kippkitts/DataSensingLab/README.md

DataSensingLab
==============

DataSensingLab

Here, you’ll find files for the DataSensingLab.  Visit the DataSensingLab [website](http://datasensinglab.com/) for more information.
