kippkitts/DataSensingLab/ONA_Sensor_Mote/Circuit Board/ONA_SensorMote_V1/ONA_SensorMote_FAB/Readme.txt

File names and descriptions:

Excellon drill rack and drill files:
	ONA_SensorMoteV1.drd
	ONA_SensorMoteV1.dri

GERBER_RS274X FILES
Component Side (top, pads, vias)
	ONA_SensorMoteV1.cmp
Solder Side (bottom, pads, bias)
	ONA_SensorMoteV1.sol
Silk screen Component side (dimension, tPlace, tNames)
	ONA_SensorMoteV1.plc
Solder Stop Mask Component Side (tStop)
	ONA_SensorMoteV1.stc
Solder Stop Mask Solder Side (bStop)
	ONA_SensorMoteV1.cmp

Kipp Bradford
Principal
The Kippworks

999 Main Street
Suite 705
Pawtucket RI 02860
USA

(401)480-7972
kb@kippworks.com
