kippkitts/DataSensingLab/ONA_Sensor_Mote/Circuit Board/BOM and Datasheets/ONA_SensorMoteBOM_V1.xlsx

REF # | Qty | Value | Device | Package | Parts | Description | Digikey | MF | MPN
ONA-1 | 1 | BAT | BAT1 | 4AA | BAT1 | Battery Pack | SBH341AS-ND
ONA-2 | 1 |  | DNP | DNP | 6V In | Battery Pack Solder Pads
ONA-3 | 1 |  | M03LOCK | 1X03_LOCK | JP1 | 0.1" Pin Header for Motion Detector
ONA-4 | 1 |  | M04SMD | 1X04-SMD | JP2, JP3 optional | 0.1" Pin Header for Programming |  |  |  | 3M9502CT-ND
ONA-5 | 1 | 0.01uF | C-EUC0805K | C0805K | C6 | CAPACITOR, European symbol | 1276-1015-1-ND
ONA-6 | 7 | 0.1uF | C-EUC0805K | C0805K | C3, C5, C11, C13, C14, C15, C18 | CAPACITOR, European symbol | 399-1170-1-ND
ONA-7 | 1 | 100pF | C-EUC0805K | C0805K | C8 | CAPACITOR, European symbol | 399-1121-1-ND
ONA-8 | 1 | 10uF | C-EUC0805K | C0805K | C7 | Capacitor, Non-Polarized 0805 | 587-1300-1-ND
ONA-9 | 4 | 1nF | C-EUC0805K | C0805K | C4, C9, C10, C12 | CAPACITOR, European symbol | 399-1147-1-ND
ONA-10 | 3 | 10uF | CAP_POL1206 | EIA3216 | C1, C2, C17 | Capacitor Polarized Tantalum Supply Filter | 399-3687-1-ND
ONA-11 | 1 | 47R | R-EU_R0805 | R0805 | R13 | RESISTOR, European symbol | 311-47ARCT-ND
ONA-12 | 1 | 100R | R-EU_R0805 | R0805 | R16 | RESISTOR, European symbol | RHM100CLCT-ND
ONA-13 | 3 | 1K | R-EU_R0805 | R0805 | R6, R7, R10 | RESISTOR, European symbol | RHM1.0KCLCT-ND
ONA-14 | 4 | 10K | R-EU_R0805 | R0805 | R1, R12, R14, R17 | RESISTOR, European symbol | RMCF0805JT10K0CT-ND
ONA-15 | 1 | 22K | R-EU_R0805 | R0805 | R11 | RESISTOR, European symbol | 311-22KARCT-ND
ONA-16 | 1 | 47k | R-EU_R0805 | R0805 | R2 | RESISTOR, European symbol | RMCF0805JT47K0CT-ND
ONA-17 | 3 | 1M | R-EU_R0805 | R0805 | R3, R8, R9 | RESISTOR, European symbol | RHM1.00MCHCT-ND
ONA-18 | 2 | 1K | 4R-NCAY16 | CAY16 | RN1, RN2 | Array Chip Resistor | Y9102CT-ND
ONA-19 | 1 | TC33X-2-1-4E (100K) | TRIMPOTTC33X | TC33X | VR1 | SMT trimmer potentiometer part number TC33X | TC33X-104ECT-ND
ONA-20 | 2 | YELLOW | LEDCHIP-LED0805 | CHIP-LED0805 | RSSI, RX | LED | 475-2560-1-ND
ONA-21 | 1 | Blue | LEDCHIP-LED0805 | CHIP-LED0805 | ACT | LED | 160-1579-1-ND
ONA-22 | 1 | White | LEDCHIP-LED0805 | CHIP-LED0805 | XB_ON | LED | 160-1738-1-ND
ONA-23 | 2 | Red | LEDCHIP-LED0805 | CHIP-LED0805 | AQ, ASSOC | LED | 350-2039-1-ND
ONA-24 | 2 | Green | LEDCHIP-LED0805 | CHIP-LED0805 | MOT, TX | LED | 475-1410-1-ND
ONA-25 | 1 | CMA-4544PF-W | ELECTRET | 9.7ELECTRET | Q3 | Electret microphone | 102-1721-ND
ONA-26 | 1 | MSP430G2553 | MSP430G2553 | PW20 | IC9 | MSP430G2553 | 296-28430-1-ND
ONA-27 | 1 | GAS_SENSOR | GAS_SENSOR | MQ-3 | U7 | MQ-3 Gas Sensor. FP not tested. Part# |  | IN HAND
ONA-28 | 1 |  | MAX4466SC70 | SC70-5L | U5 | MAX4466 Mic Amp
ONA-29 | 1 | LM61 | LM61 | SOT23 | IC4 | Temperature Sensor | LM61BIM3X/NOPBCT-ND | TI | LM61
ONA-30 | 1 | LT5534 | LTC55 | SC70 | U6 | RF Signal Detector | LT5534ESC6#TRMPBFCT-ND
ONA-31 | 1 | MC33269ST-3.3T3 | MC33269ST-3.3T3 | SOT223 | IC1 | Adjustable Output Low Dropout Voltage Regulator 800 mA | MC33269ST-3.3T3GOSCT-ND
ONA-32 | 1 | MC33269ST-3.3T3 | MC33269ST-3.3T3 | SOT223 | IC2 | Adjustable Output Low Dropout Voltage Regulator 800 mA | NCP1117ST50T3GOSCT-ND
ONA-33 | 1 | MOSFET-NCHANNELSMD | MOSFET-NCHANNELSMD | SOT23-3 | Q1 | 1A Logic Level Mosfet | 785-1009-1-ND
ONA-34 | 1 | TS42 | TS42 | TS42 | RESET | TS42 | 679-2379-1-ND
ONA-35 | 1 | XBEE-SMT | XBEE-SMT | XBEE-SMT | SM34 | XB1 |  | XBee(TM)/XBee-PRO(TM) ZB SMT RF Modules.
ONA-36 | 2 | XBEE-HEADER | XBEE-PRO | XBEE-PRO | XB2 | XBee (TM) /XBee-PRO™ HEADER | S5751-10-ND |  | XBP24-AWI-001
ONA-37 | 2 | ferrite | INDUCTOR0603 | 603 | L1, L2 | Inductors | 445-1552-1-ND
 |  |  |  |  |  | Battery thing | SLPD-01-BLK-ND
 |  |  |  |  |  | LED | 897-1145-ND
