kippkitts/DataSensingLab/ONA_Sensor_Mote/Circuit Board/ONA_SensorMote_V1/ONA_SensorMoteV1_BRD.pdf

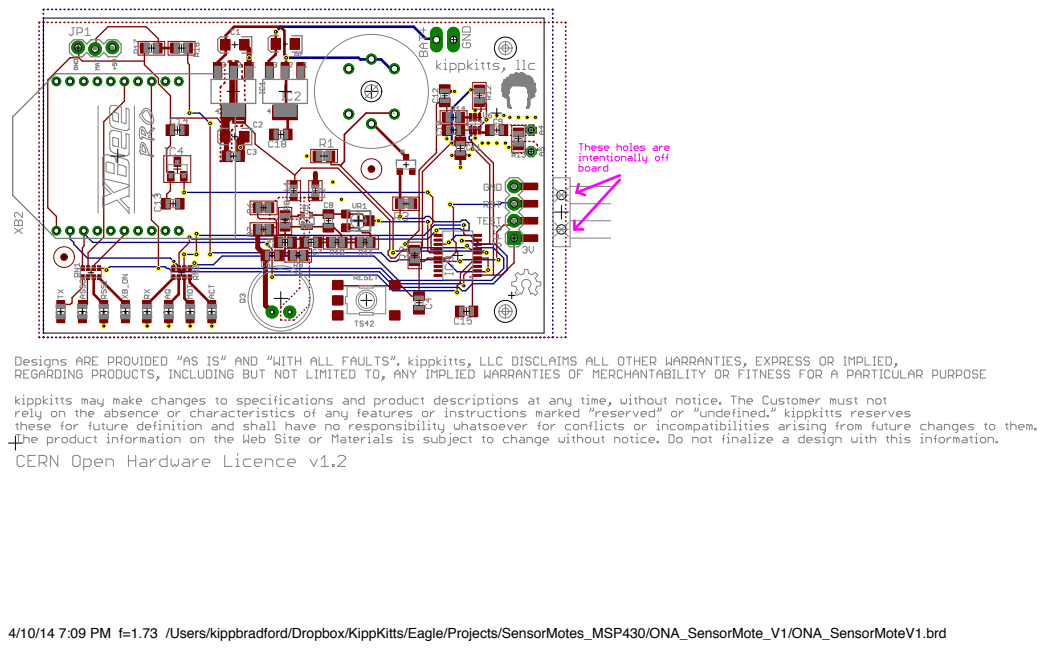
[picture p1: page 1]

4/10/14 7:09 PM f=1.73 /Users/kippbradford/Dropbox/KippKitts/Eagle/Projects/SensorMotes_MSP430/ONA_SensorMote_V1/ONA_SensorMoteV1.brd
