kippkitts/DataSensingLab/ONA_Sensor_Mote/Circuit Board/ONA_SensorMote_V1/ONA_SensorMoteV1_Sch.pdf

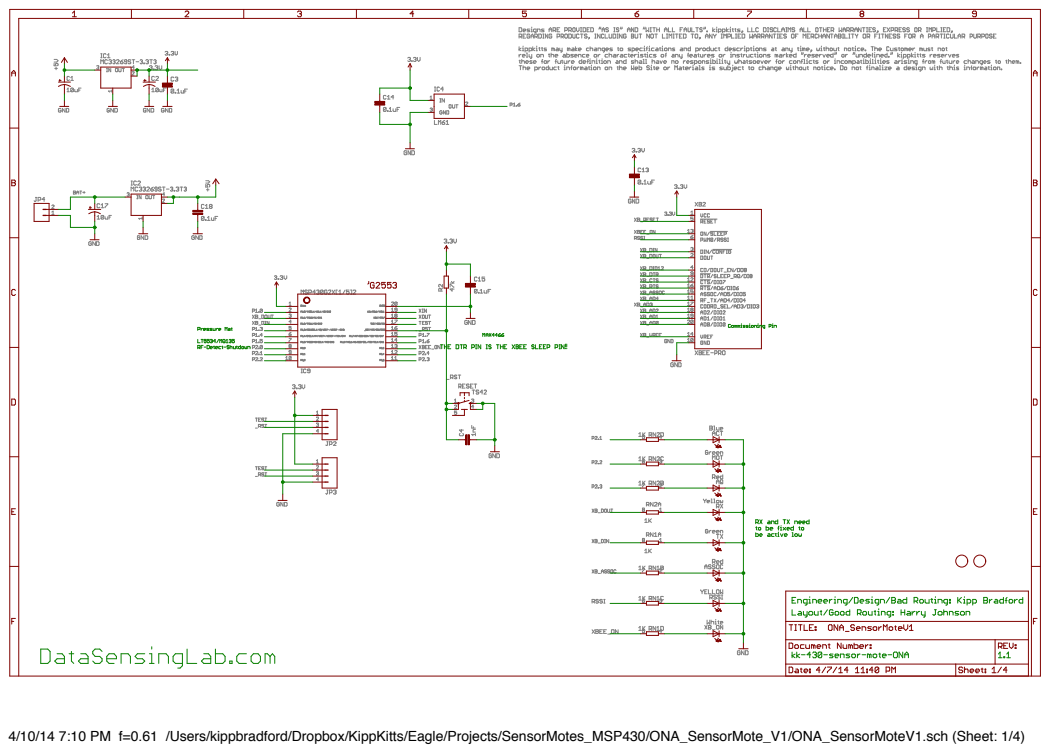
[picture p2: page 1]

4/10/14 7:10 PM f=0.61 /Users/kippbradford/Dropbox/KippKitts/Eagle/Projects/SensorMotes_MSP430/ONA_SensorMote_V1/ONA_SensorMoteV1.sch (Sheet: 1/4)

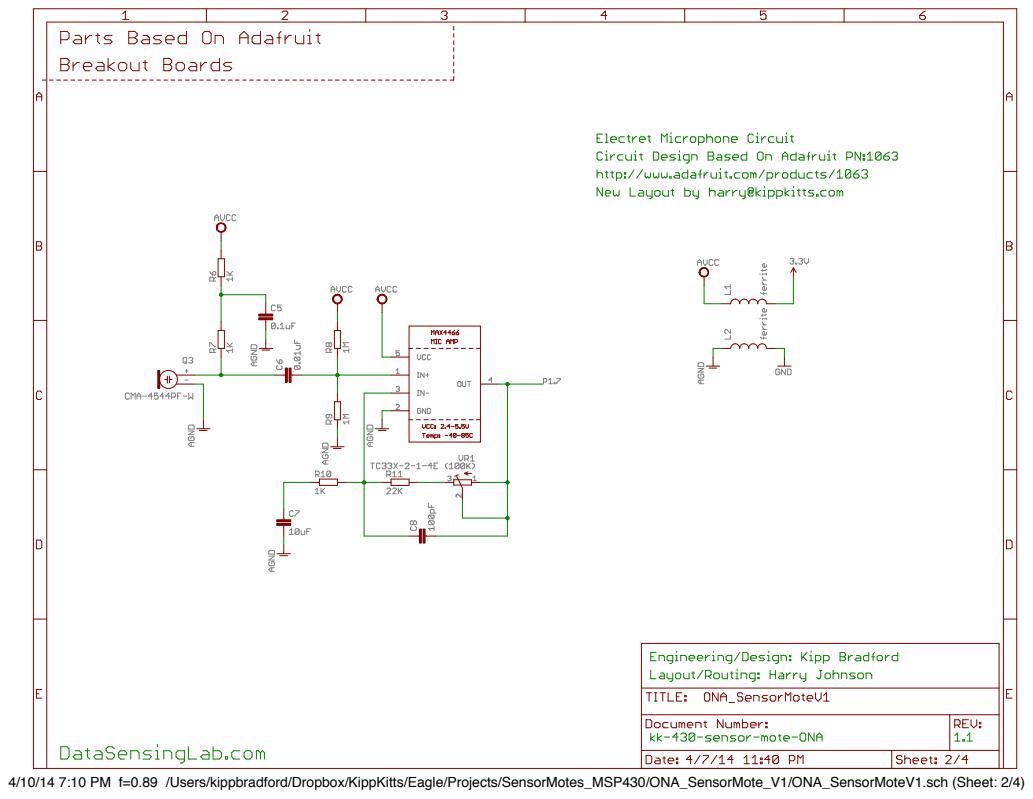
[picture p3: page 2]

4/10/14 7:10 PM f=0.89 /Users/kippbradford/Dropbox/KippKitts/Eagle/Projects/SensorMotes_MSP430/ONA_SensorMote_V1/ONA_SensorMoteV1.sch (Sheet: 2/4)

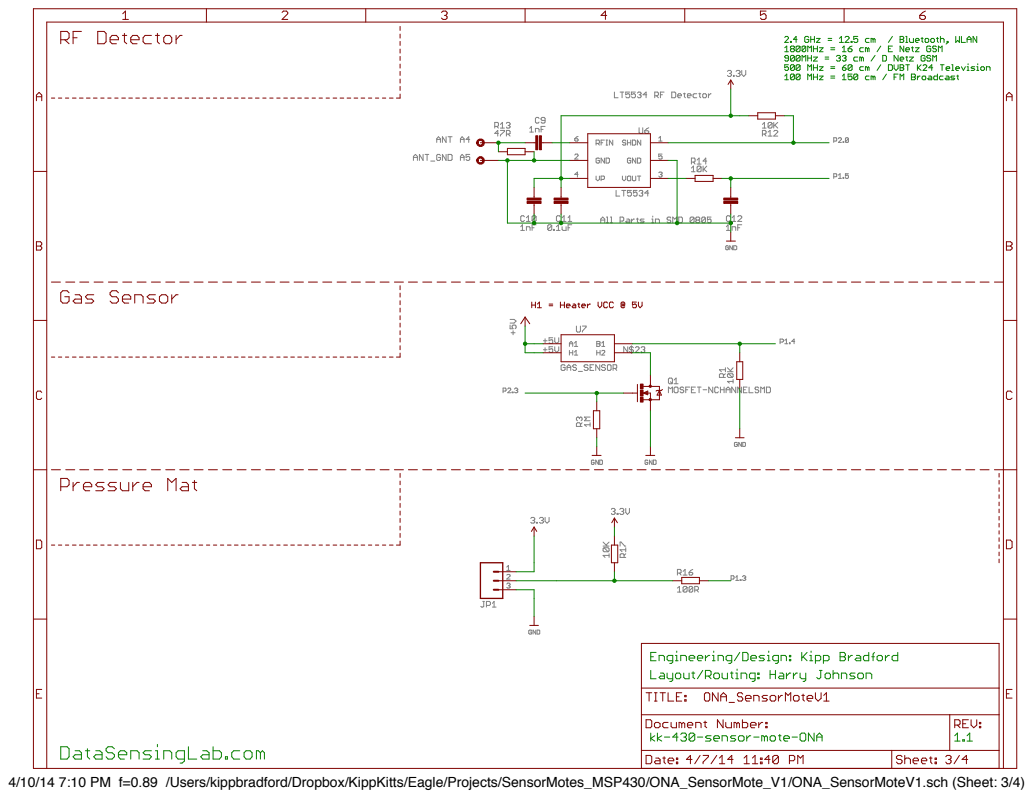
[picture p4: page 3]

4/10/14 7:10 PM f=0.89 /Users/kippbradford/Dropbox/KippKitts/Eagle/Projects/SensorMotes_MSP430/ONA_SensorMote_V1/ONA_SensorMoteV1.sch (Sheet: 3/4)

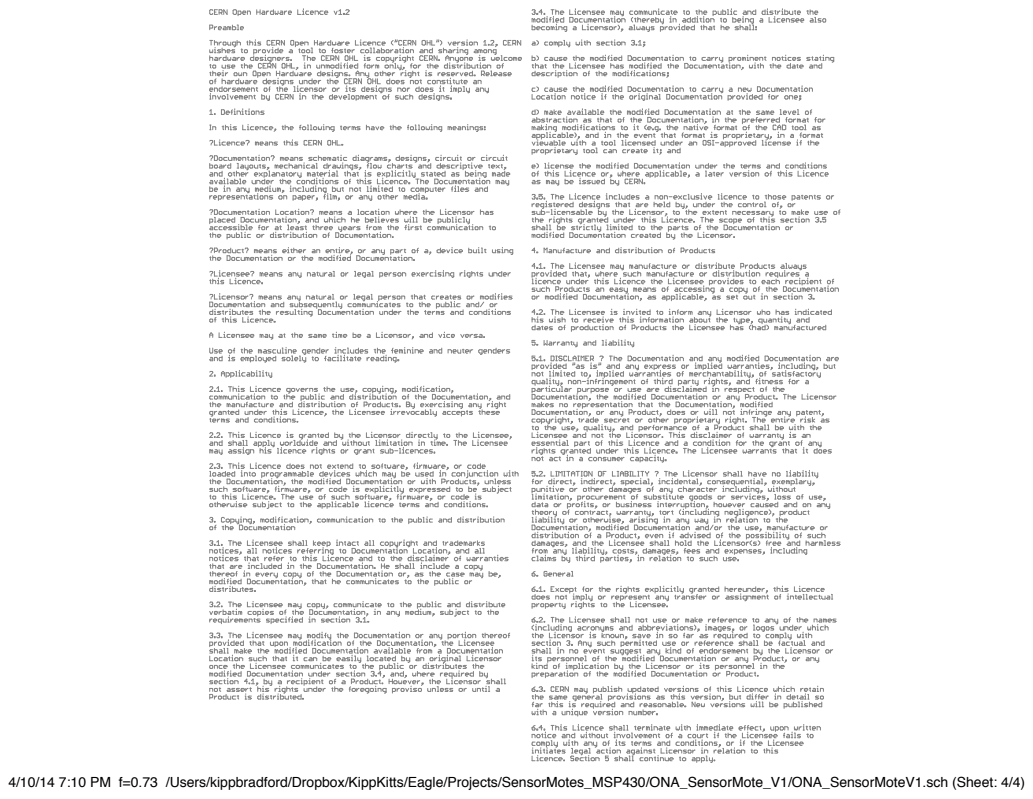
[picture p5: page 4]

4/10/14 7:10 PM f=0.73 /Users/kippbradford/Dropbox/KippKitts/Eagle/Projects/SensorMotes_MSP430/ONA_SensorMote_V1/ONA_SensorMoteV1.sch (Sheet: 4/4)
