kippkitts/DataSensingLab/DSL_Sensor_Mote/Eagle/SensorMoteSMT_V1.1Config0_PCB.pdf

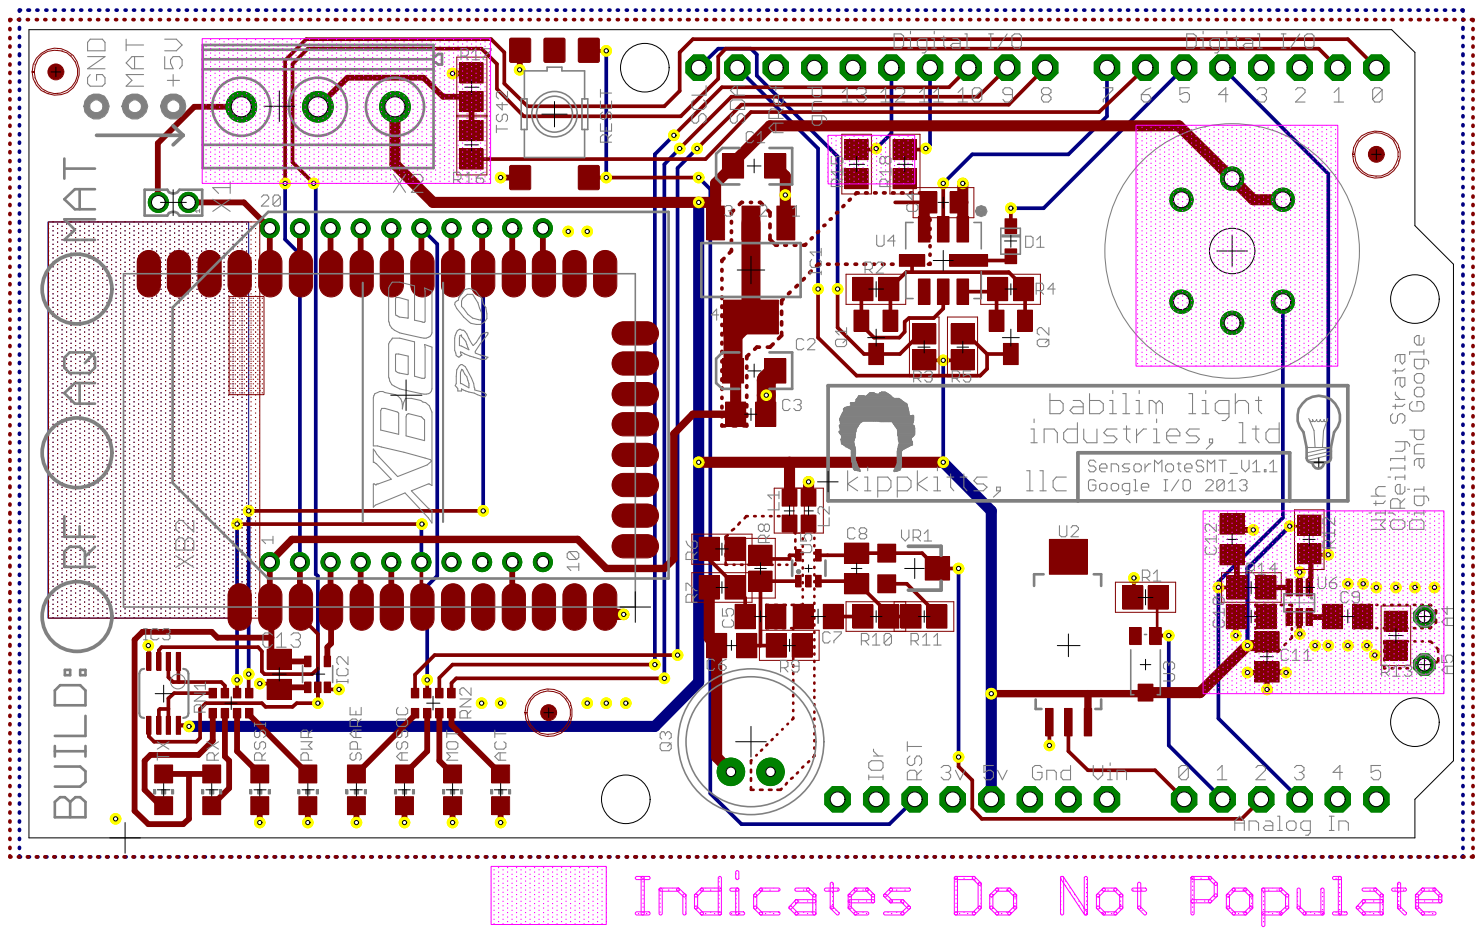
[picture p6: page 1]
