kippkitts/DataSensingLab/DSL_Sensor_Mote/Eagle/SensorMoteSMT_V1.1Config0_SCH.pdf

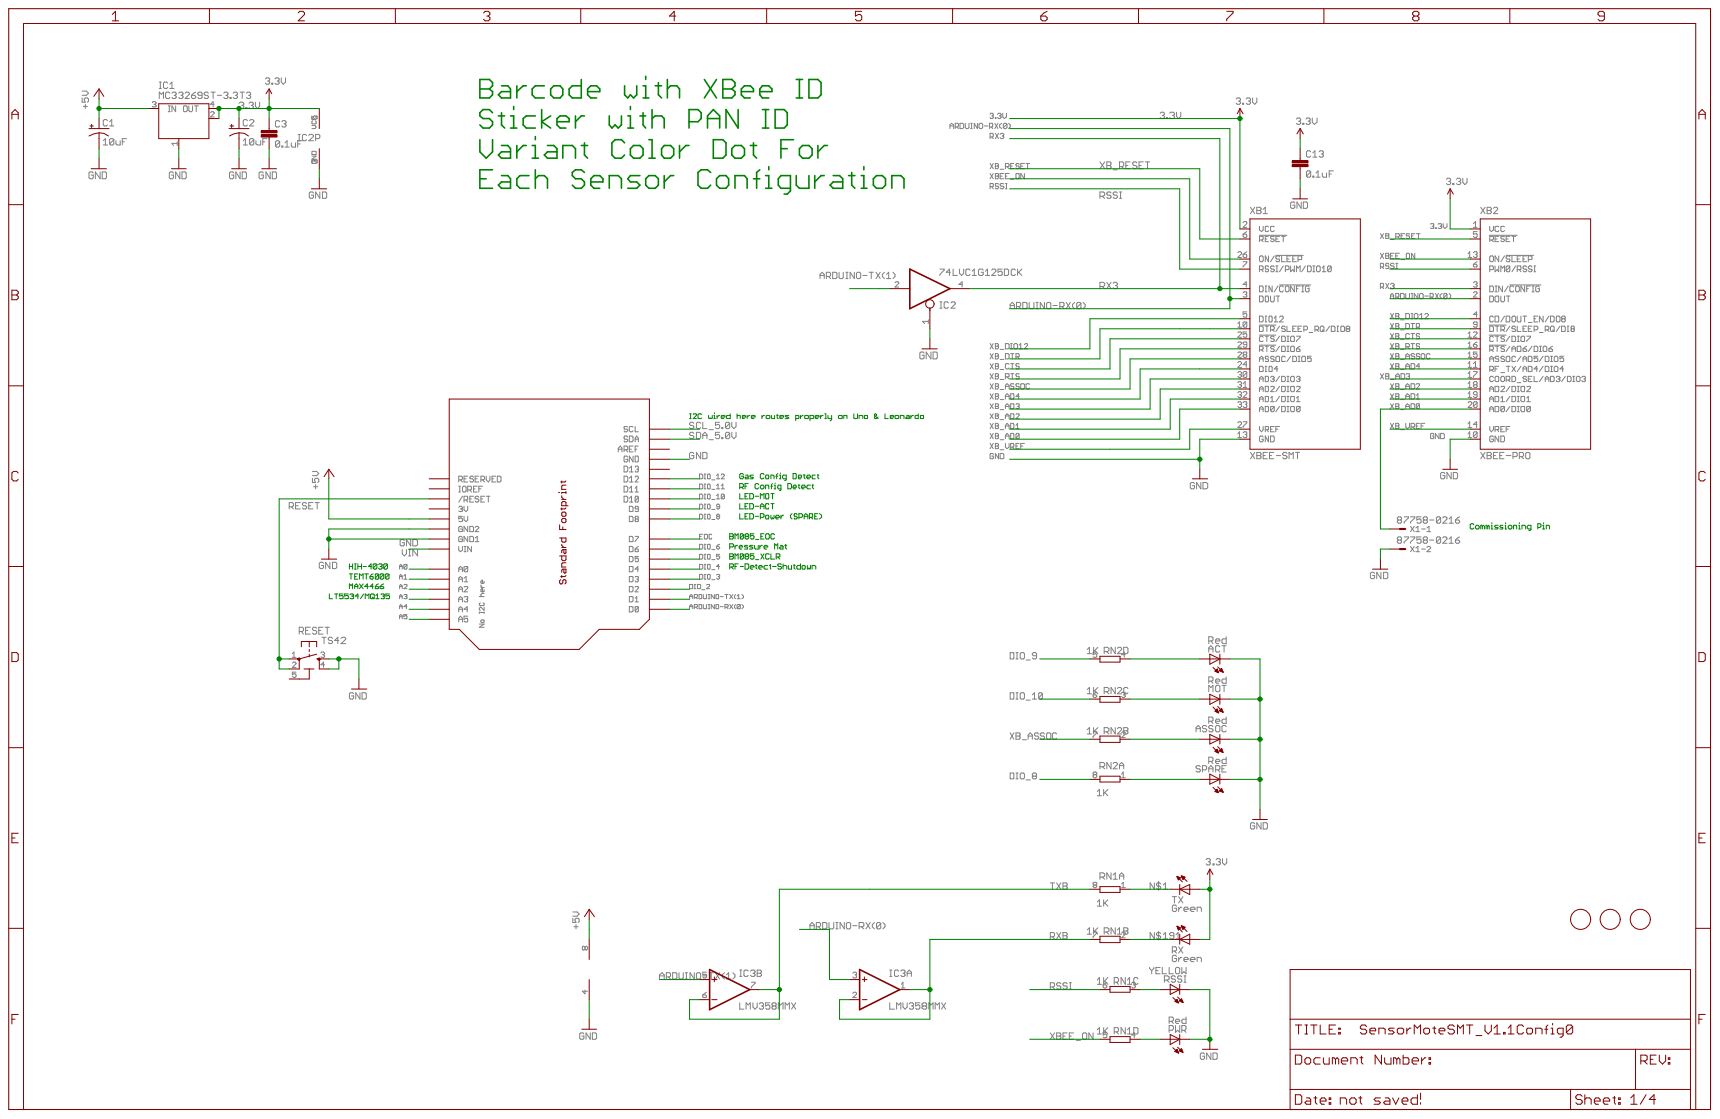
[picture p7: page 1]

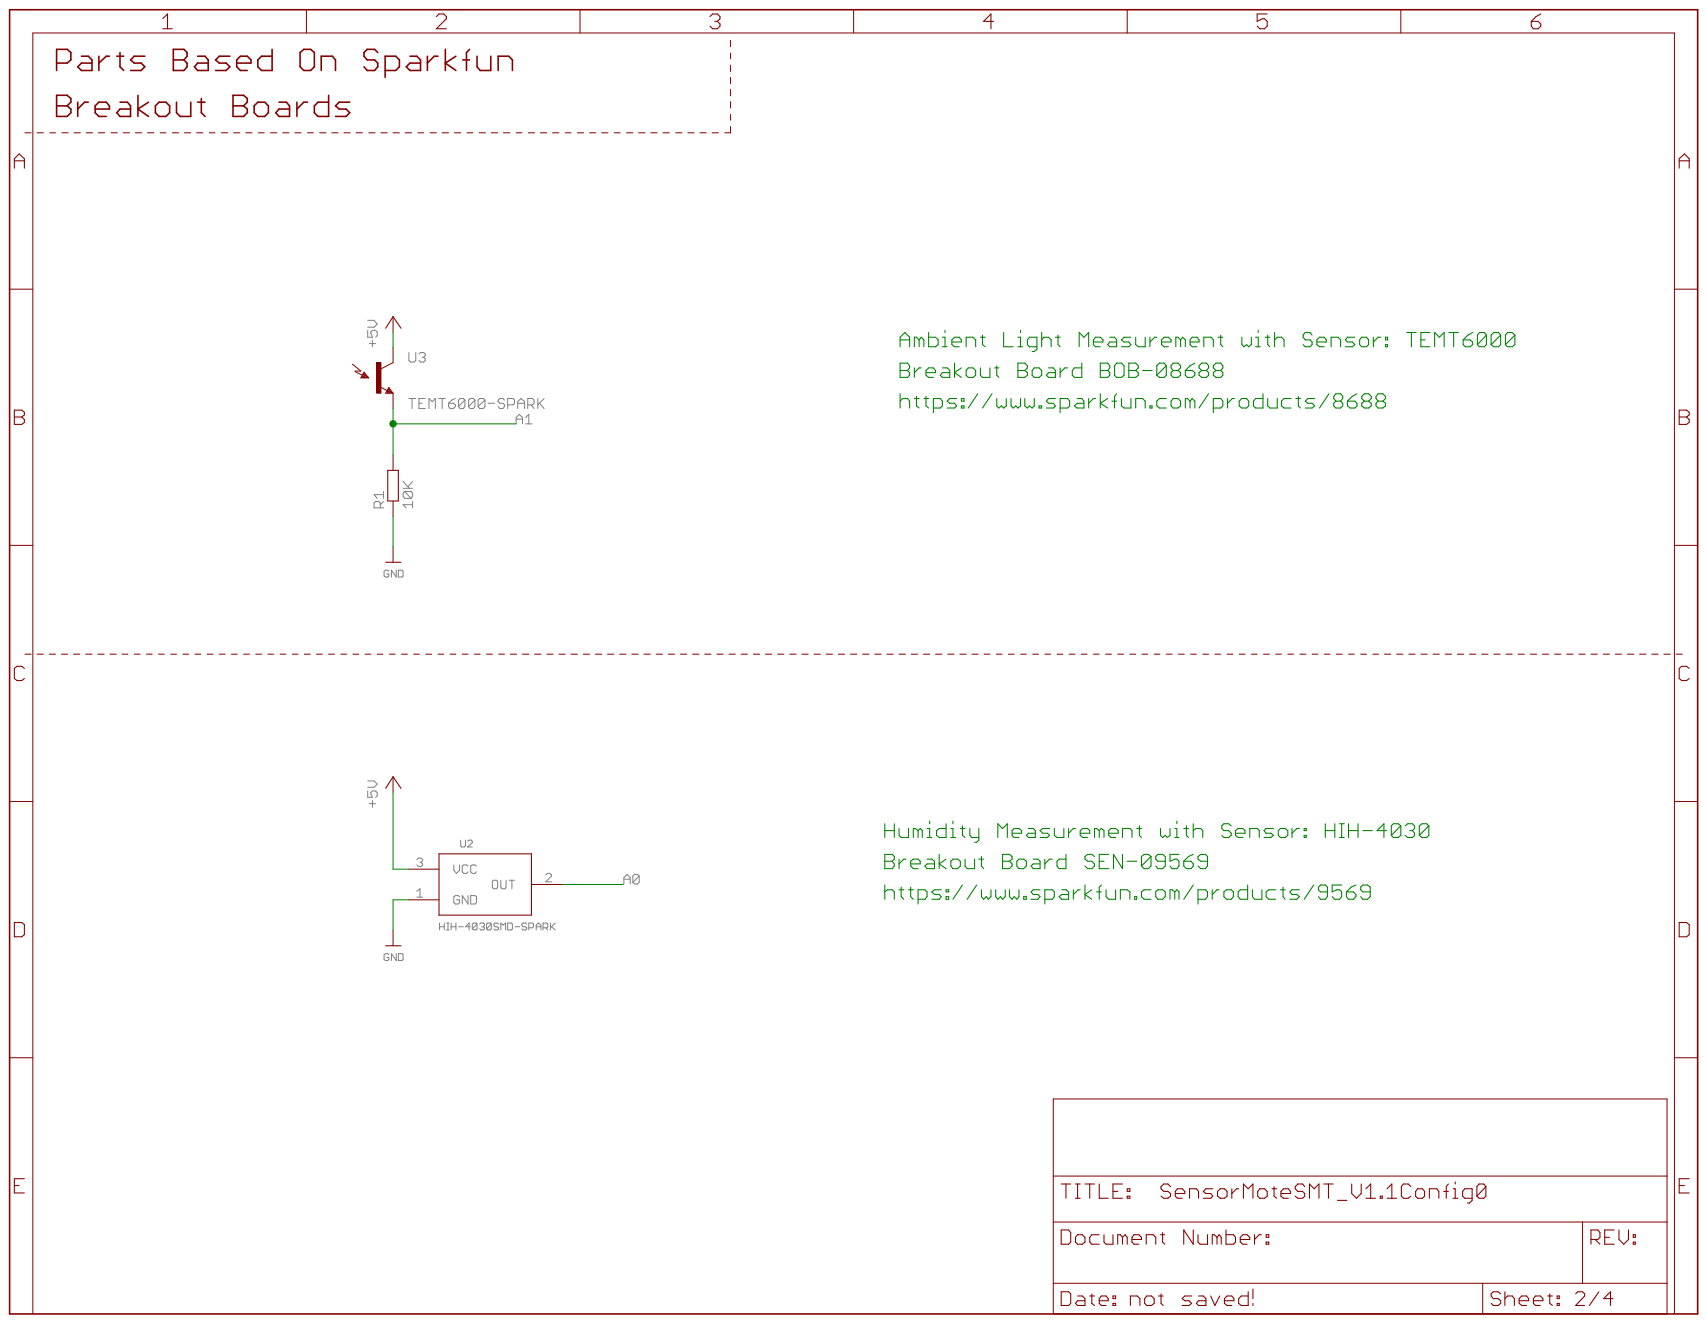
[picture p8: page 2]

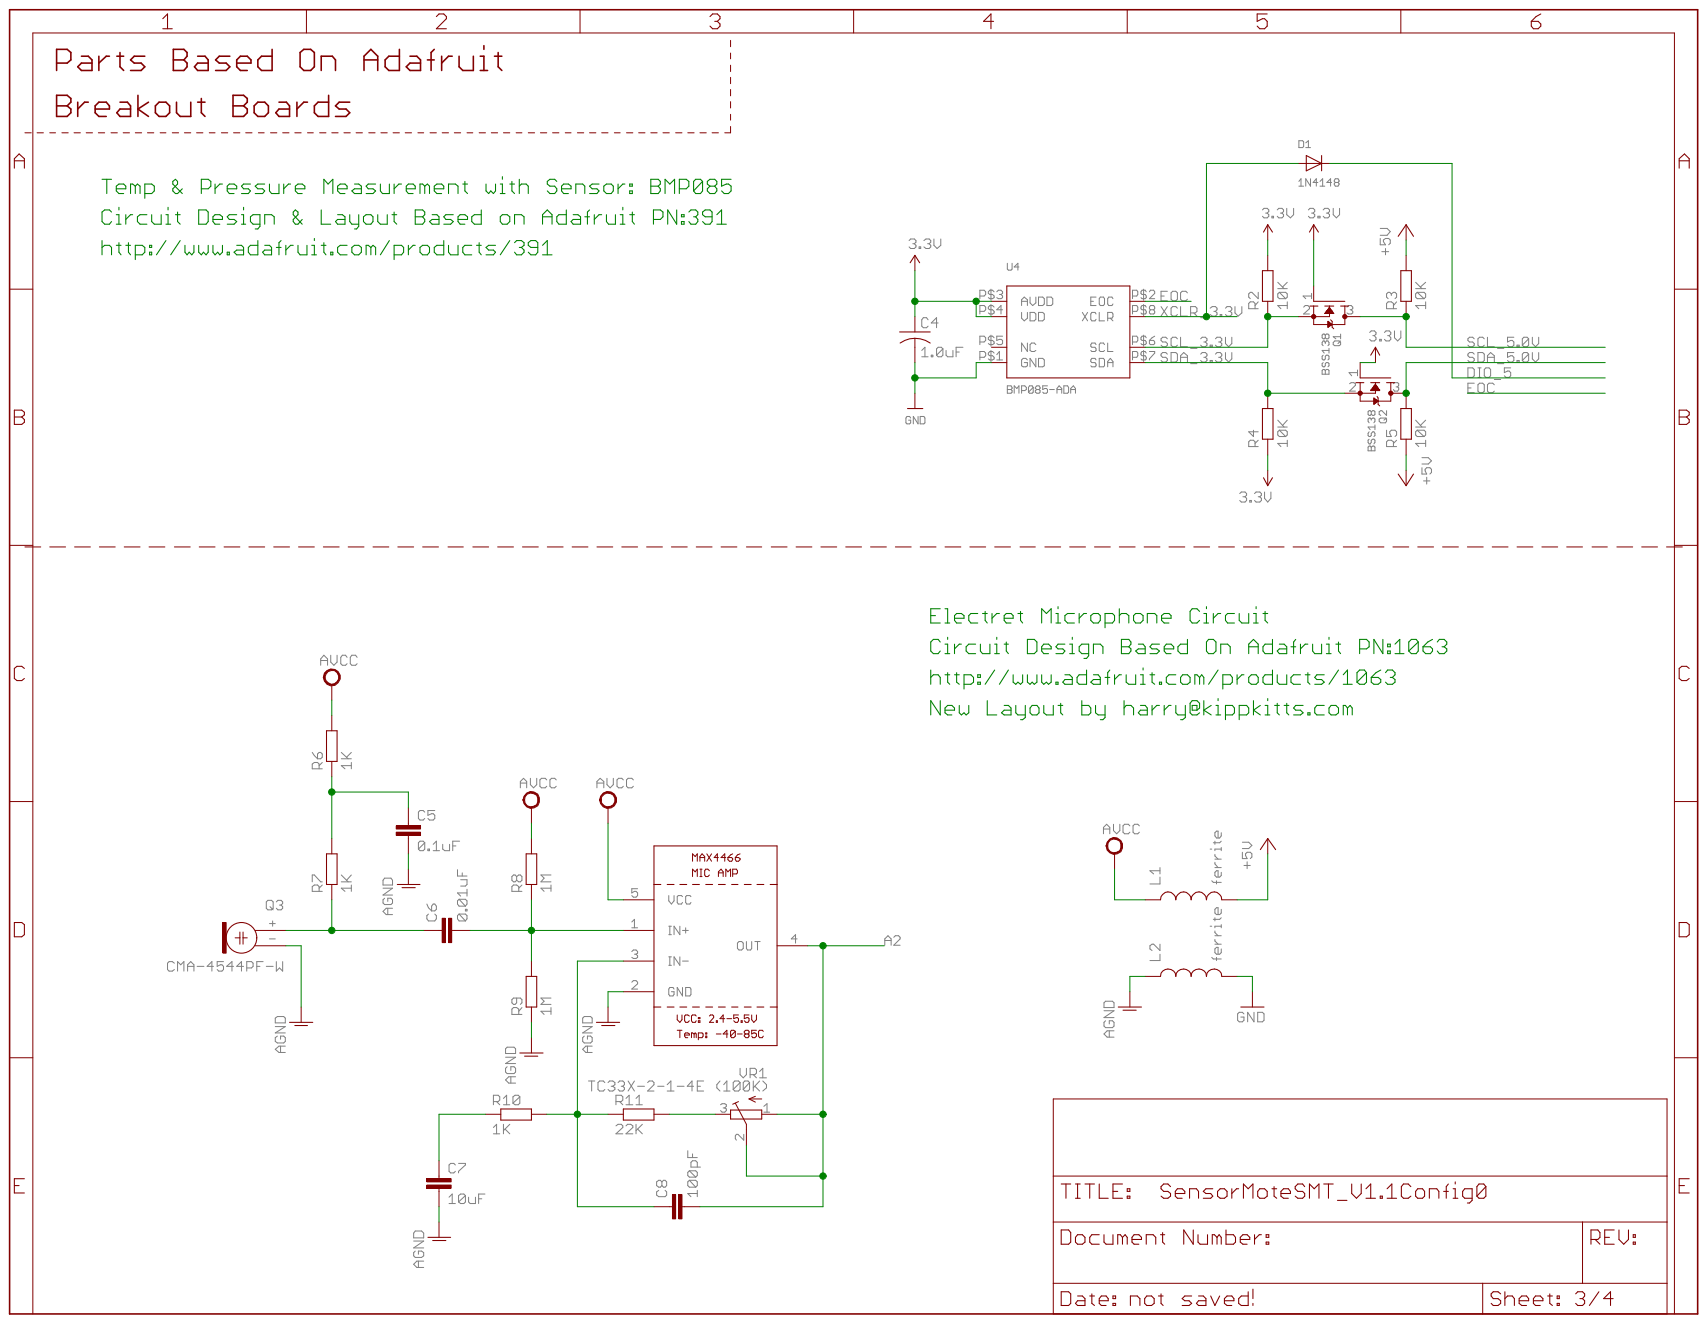
[picture p9: page 3]

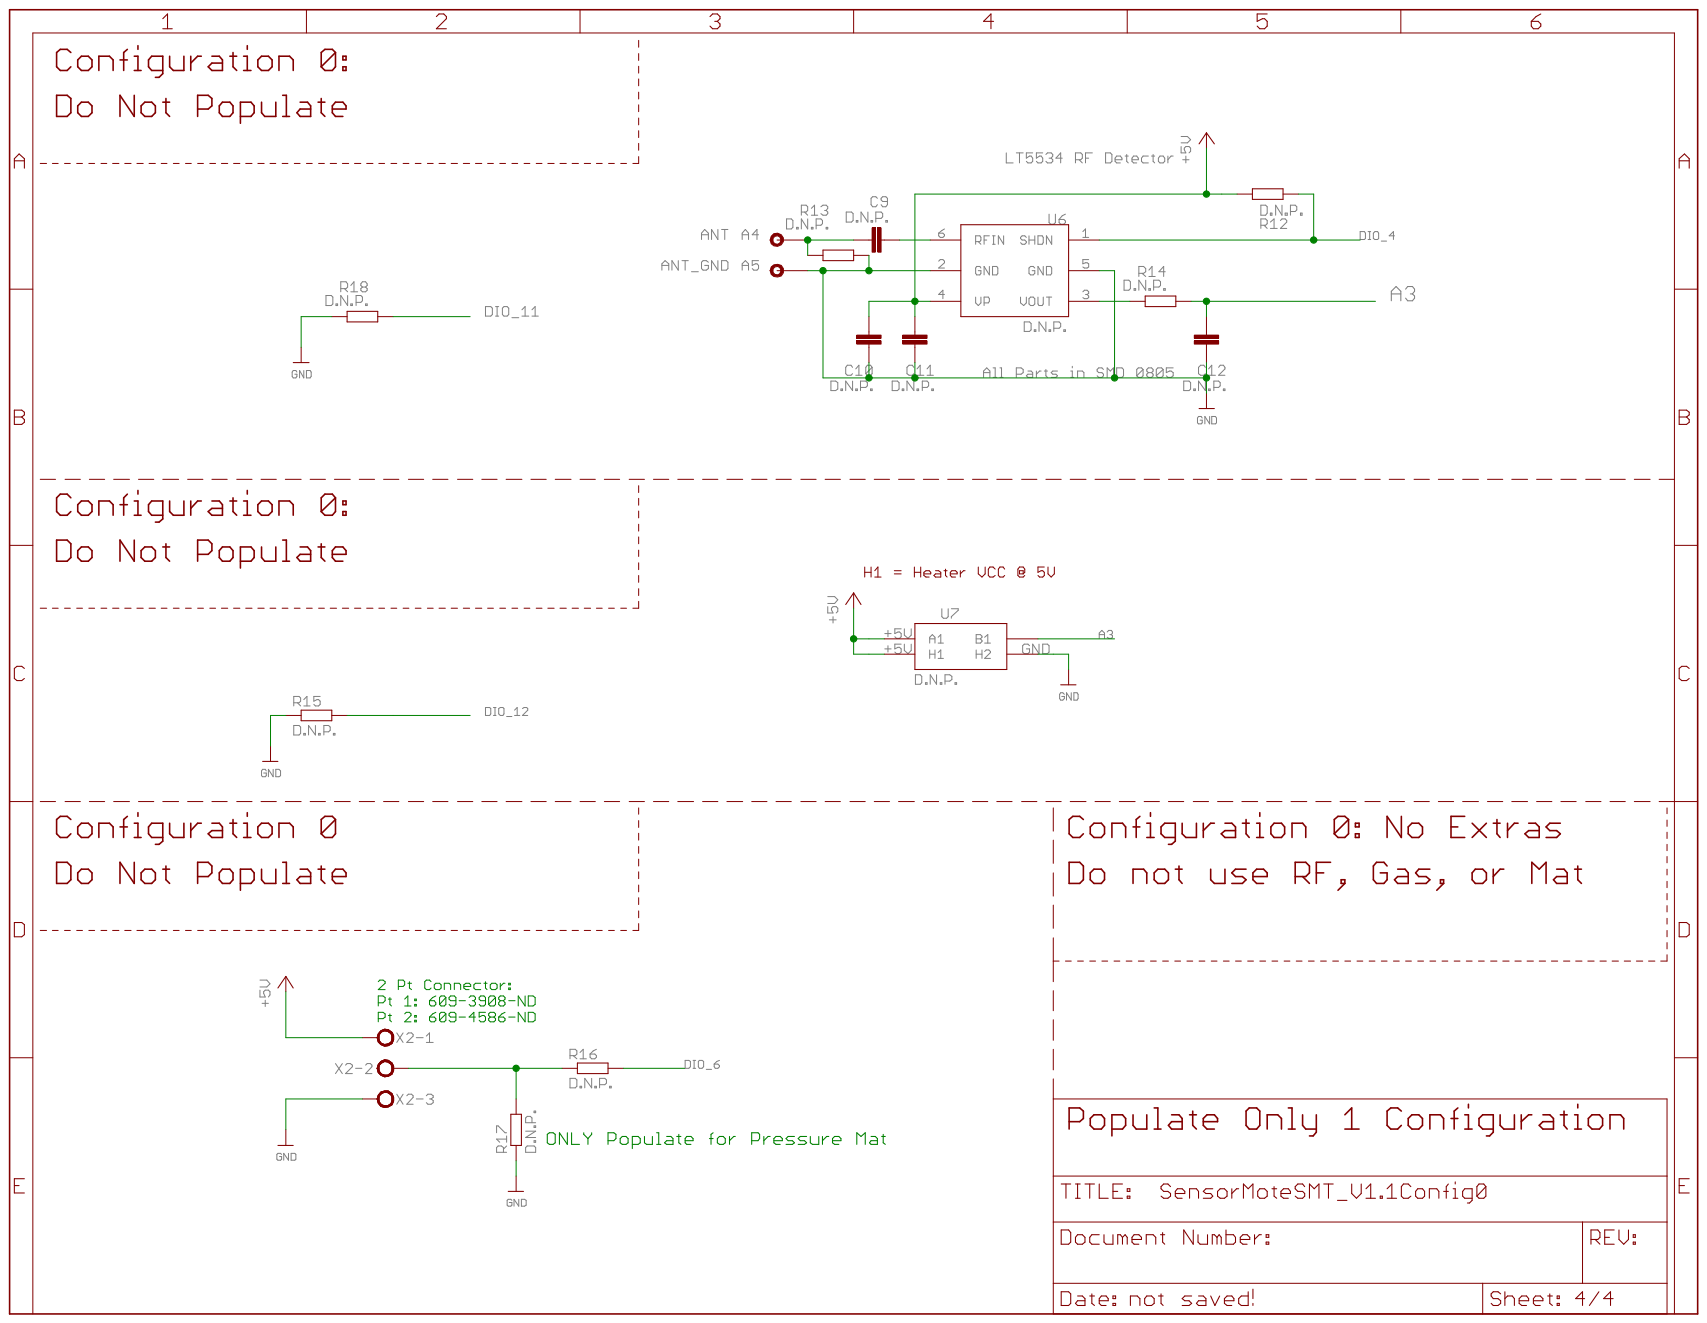
[picture p10: page 4]
