kippkitts/DataSensingLab/DSL_Sensor_Mote/Eagle/SensorMoteSMT_V1.1Config2_GAS_PCB.pdf

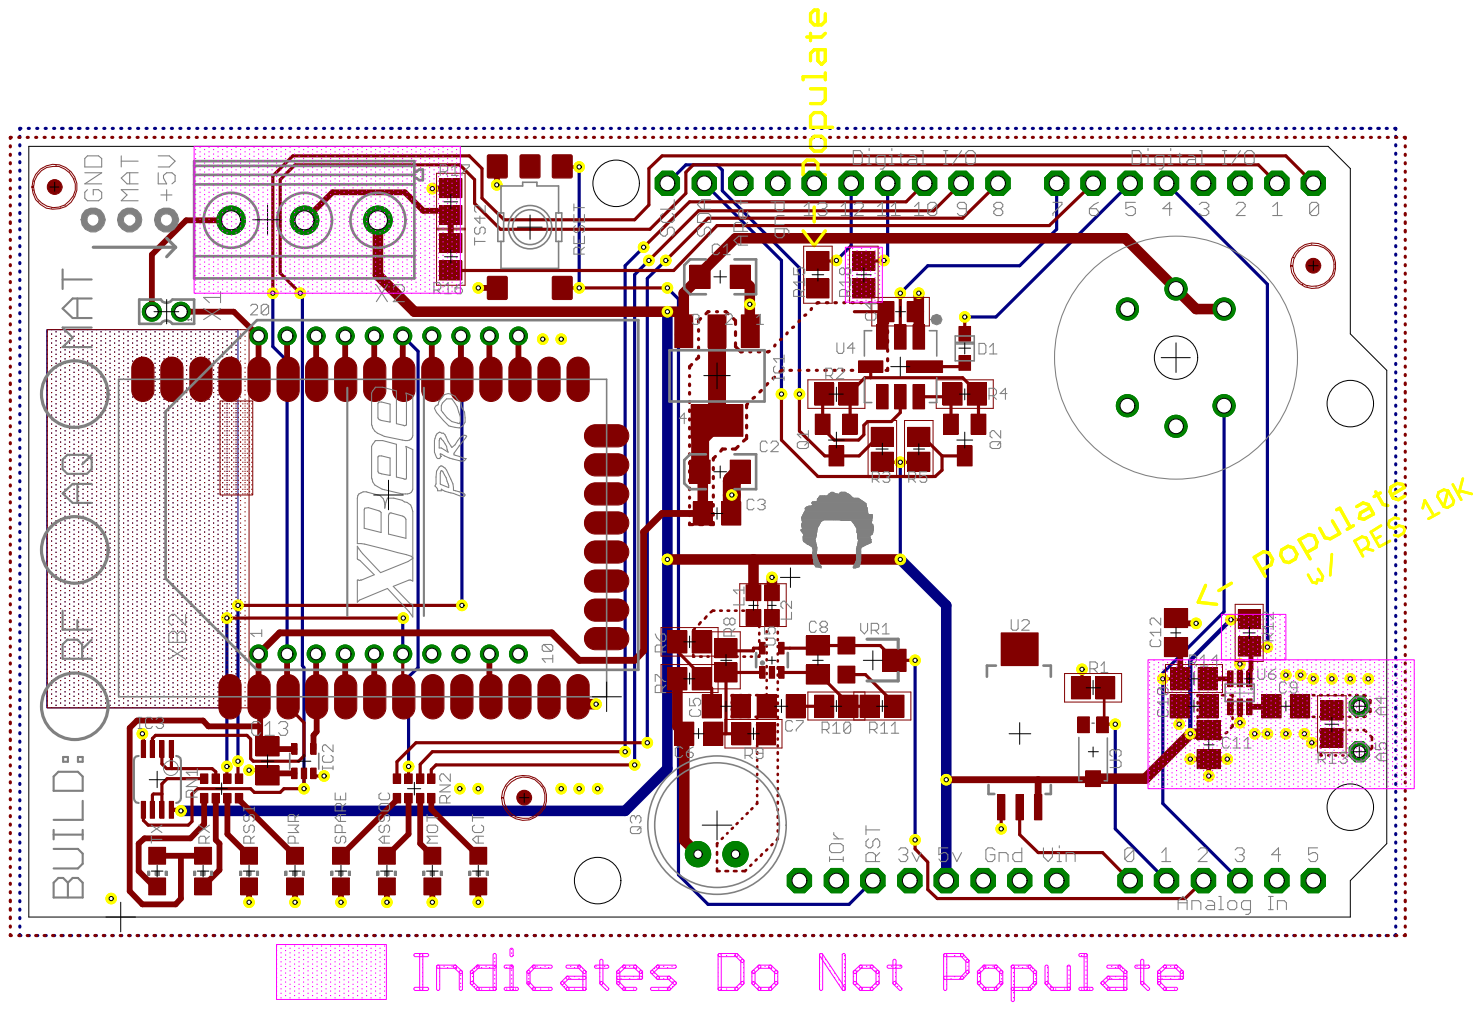
[picture p11: page 1]
