kippkitts/DataSensingLab/DSL_Sensor_Mote/Eagle/SensorMoteSMT_V1.1Config2_GAS_SCH.pdf

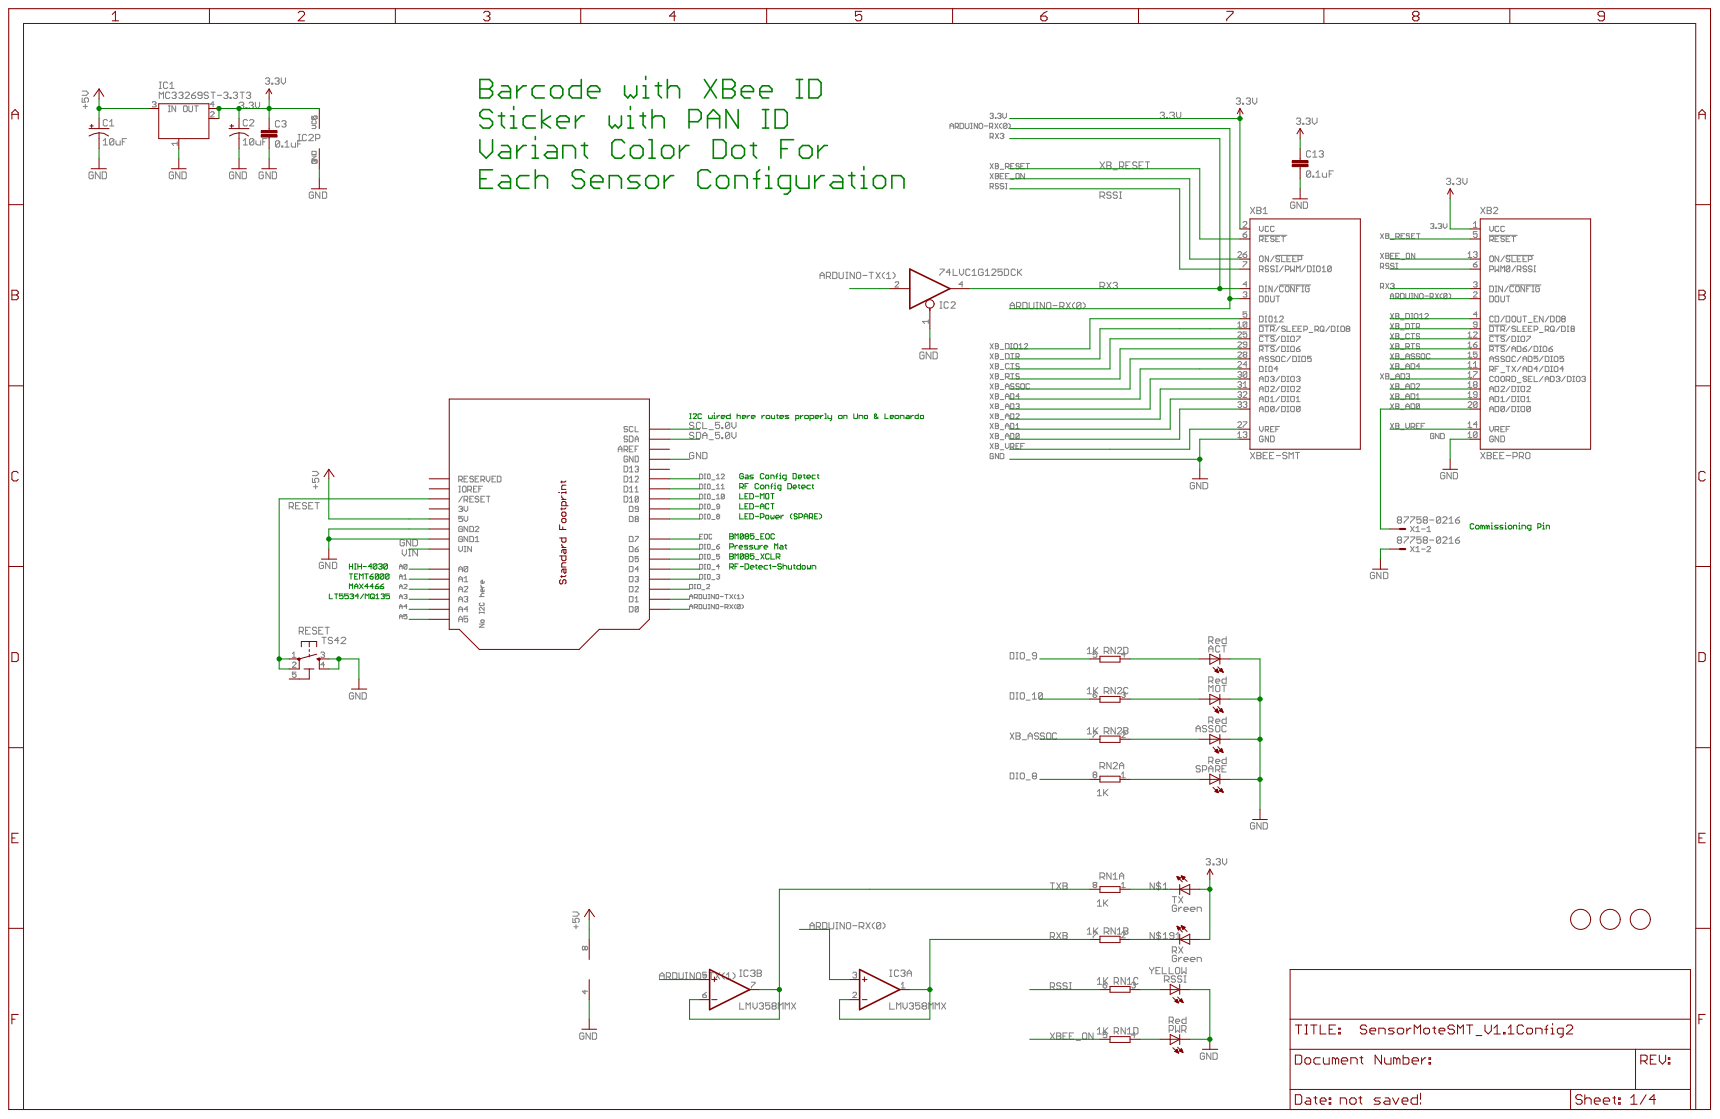
[picture p12: page 1]

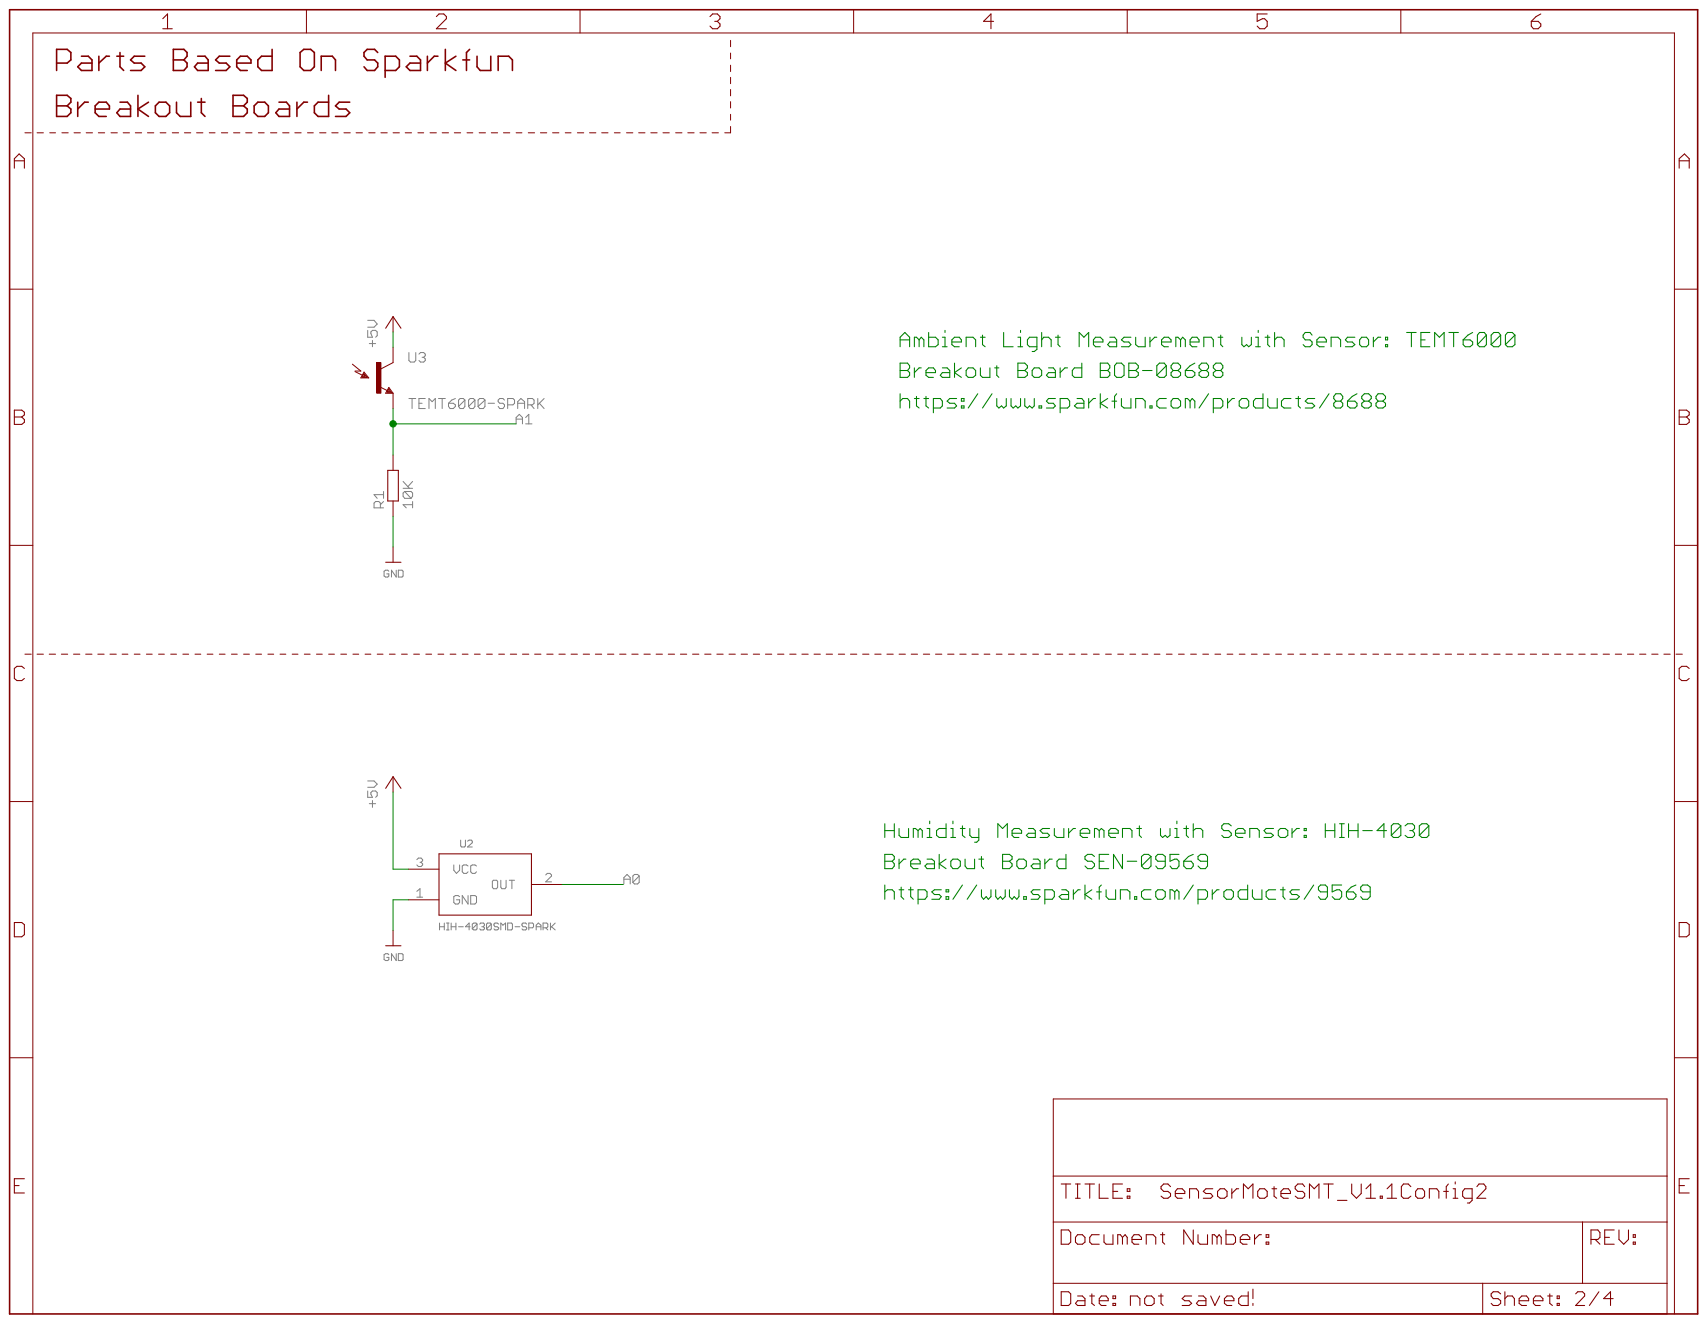
[picture p13: page 2]

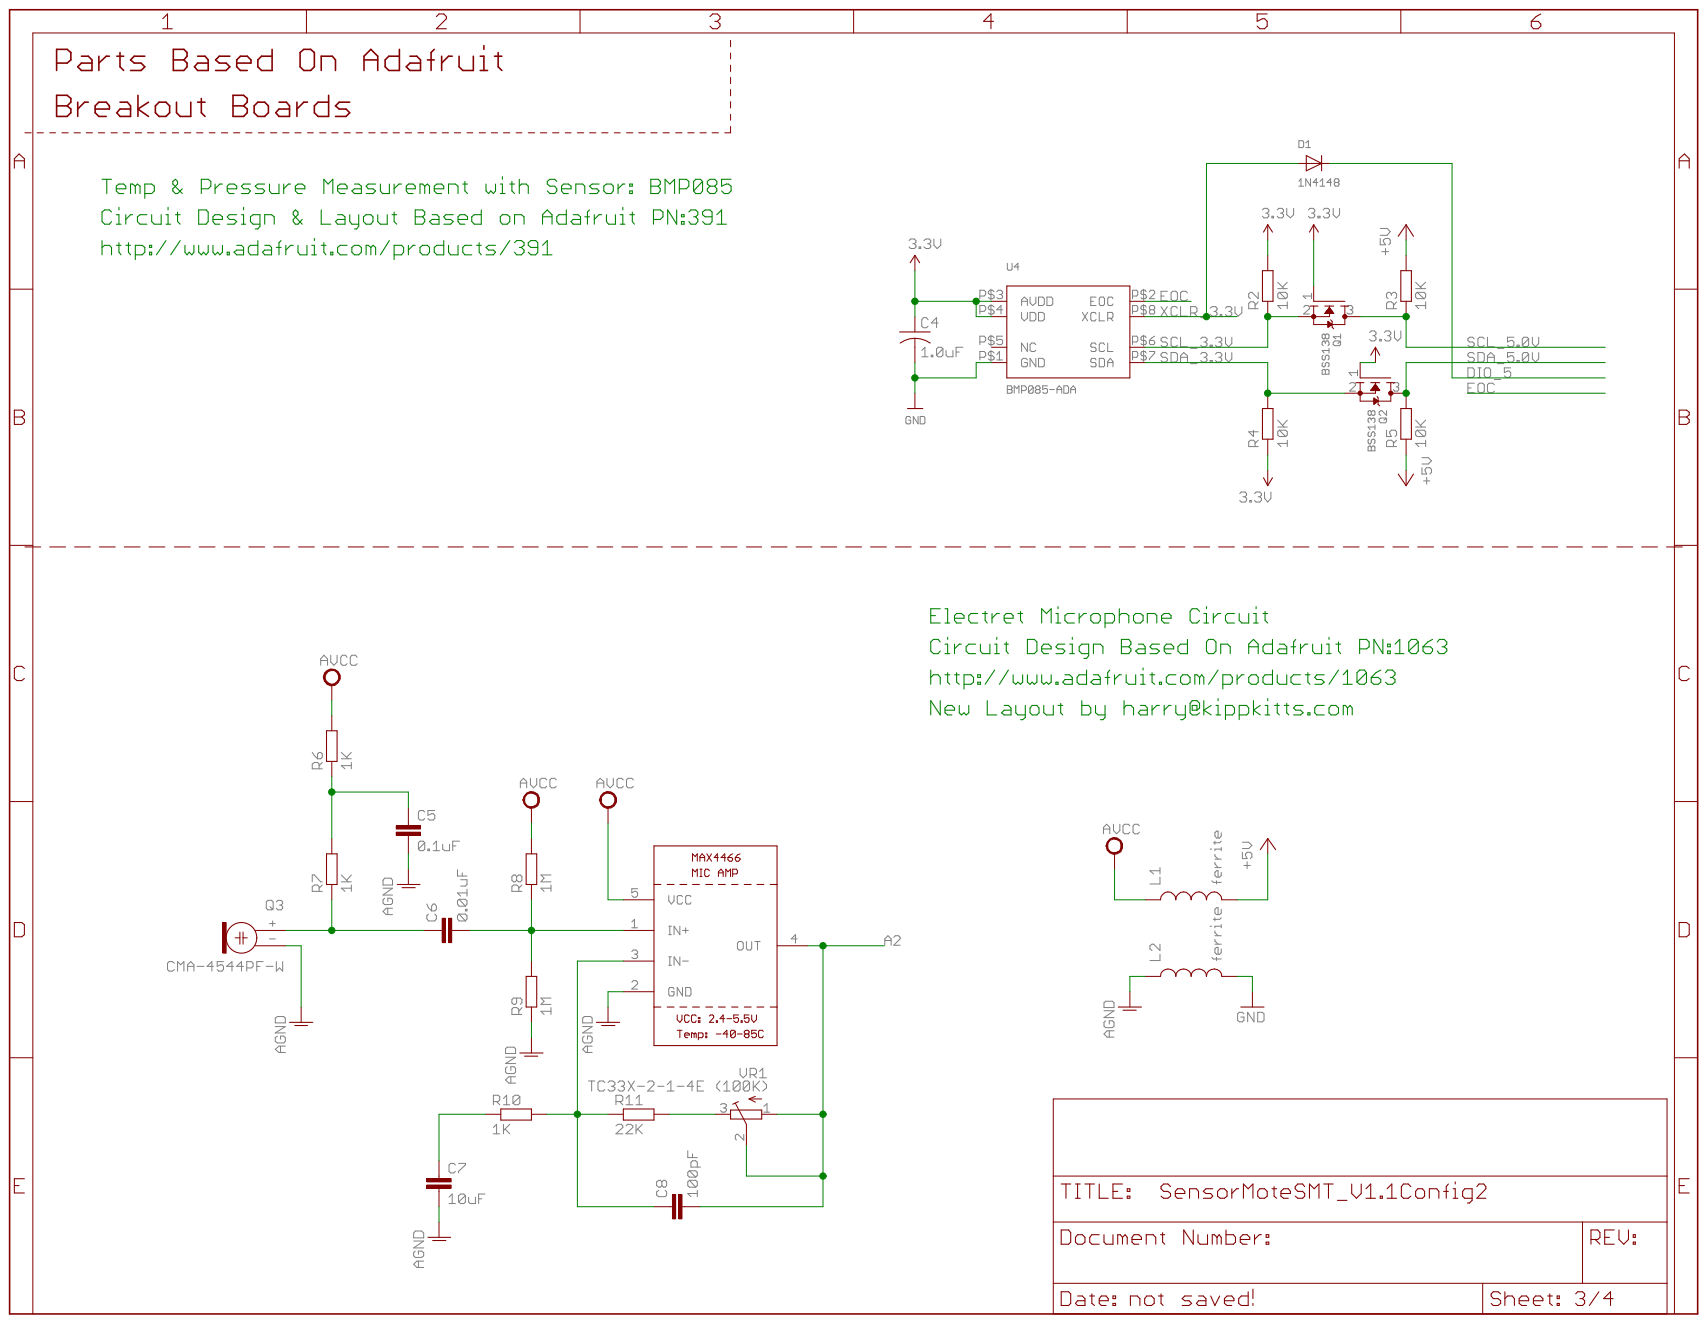
[picture p14: page 3]

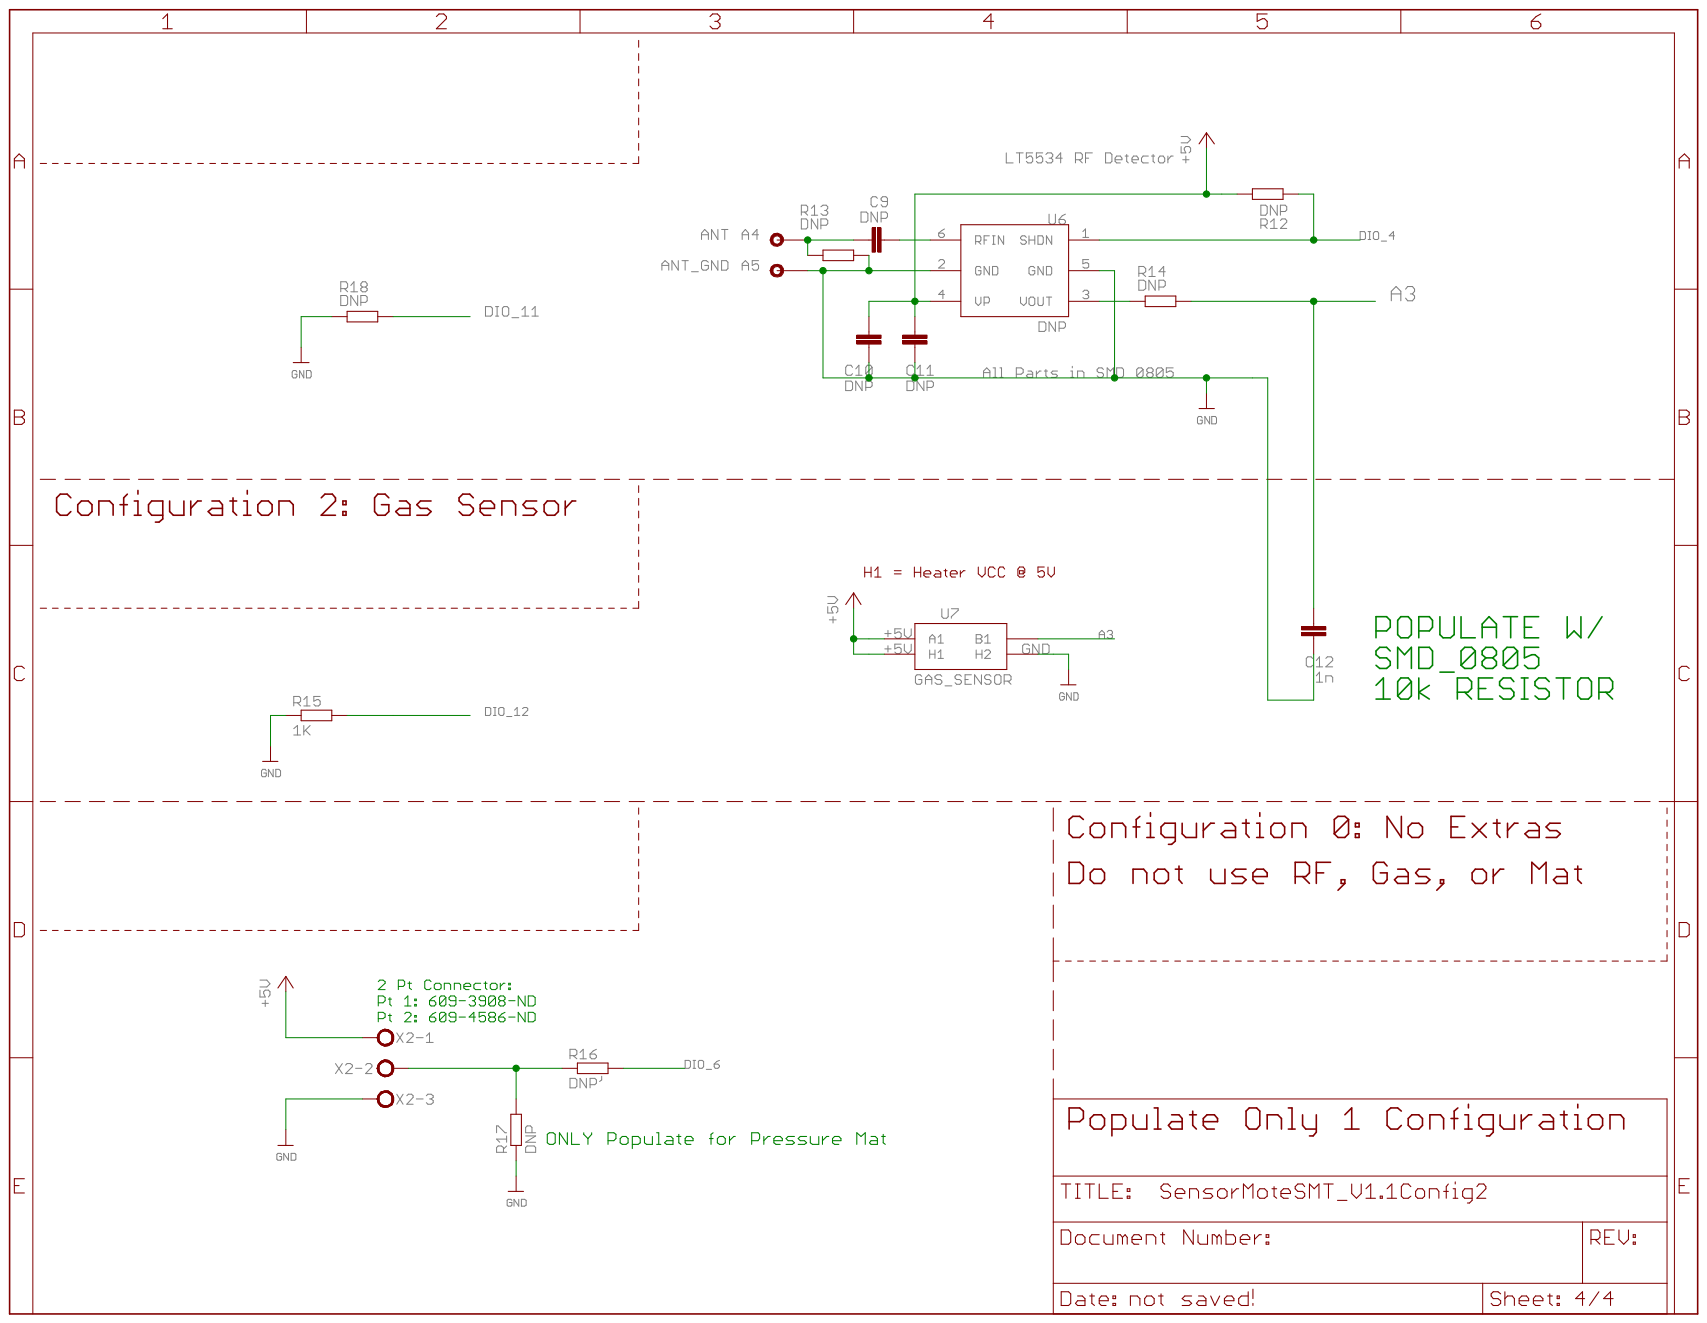
[picture p15: page 4]
