kippkitts/DataSensingLab/DSL_Sensor_Mote/Eagle/SensorMoteSMT_V1.1Config3_MAT_PCB.pdf

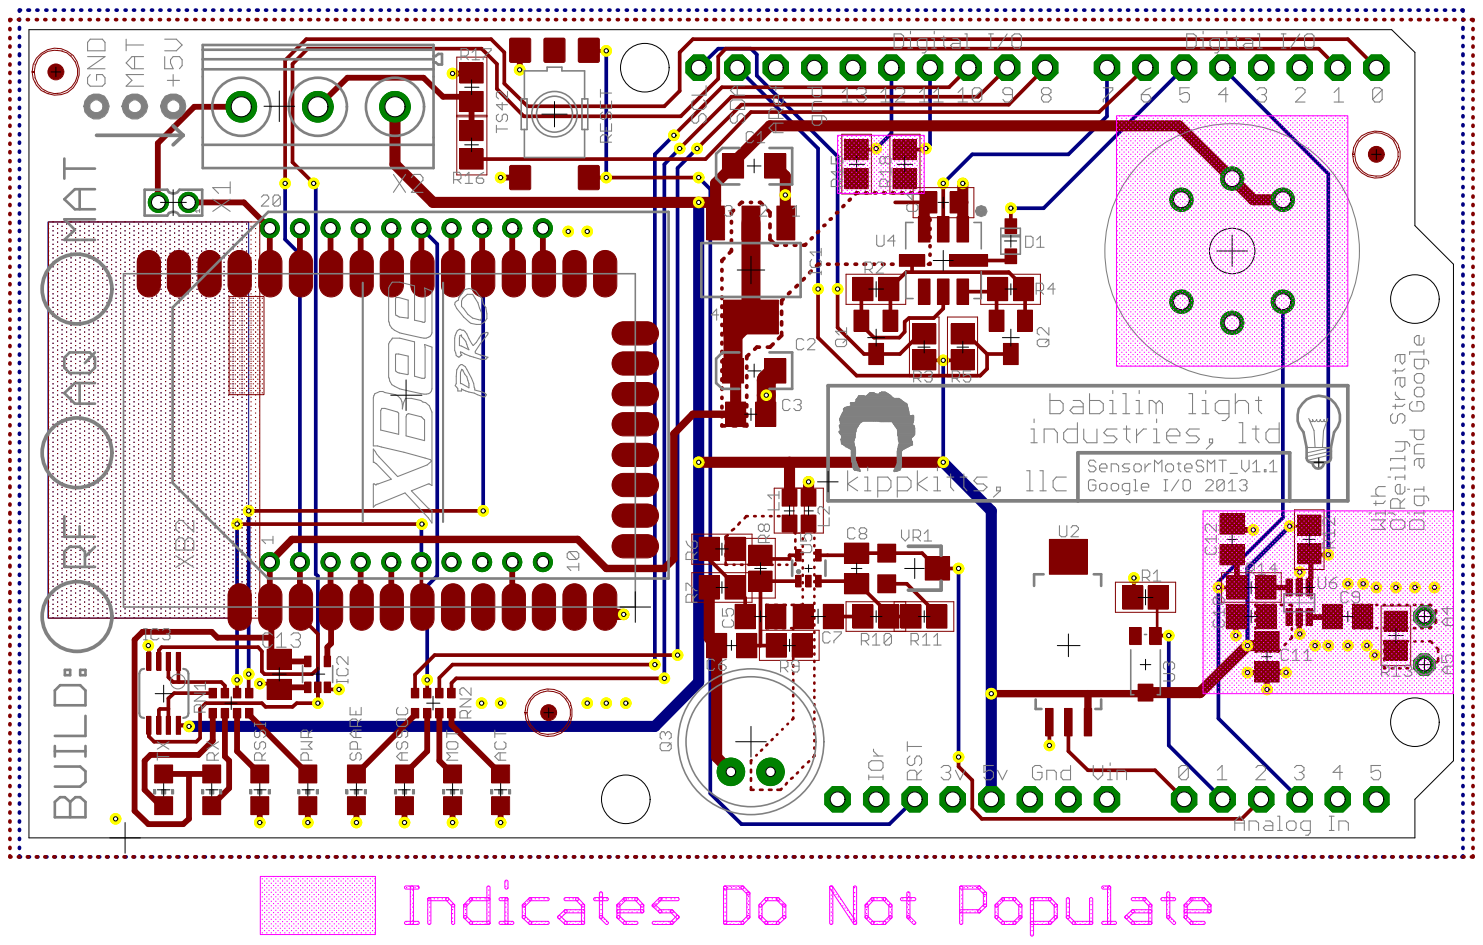
[picture p16: page 1]
