kippkitts/DataSensingLab/DSL_Sensor_Mote/Eagle/SensorMoteSMT_V1.1Config3_MAT_SCH.pdf

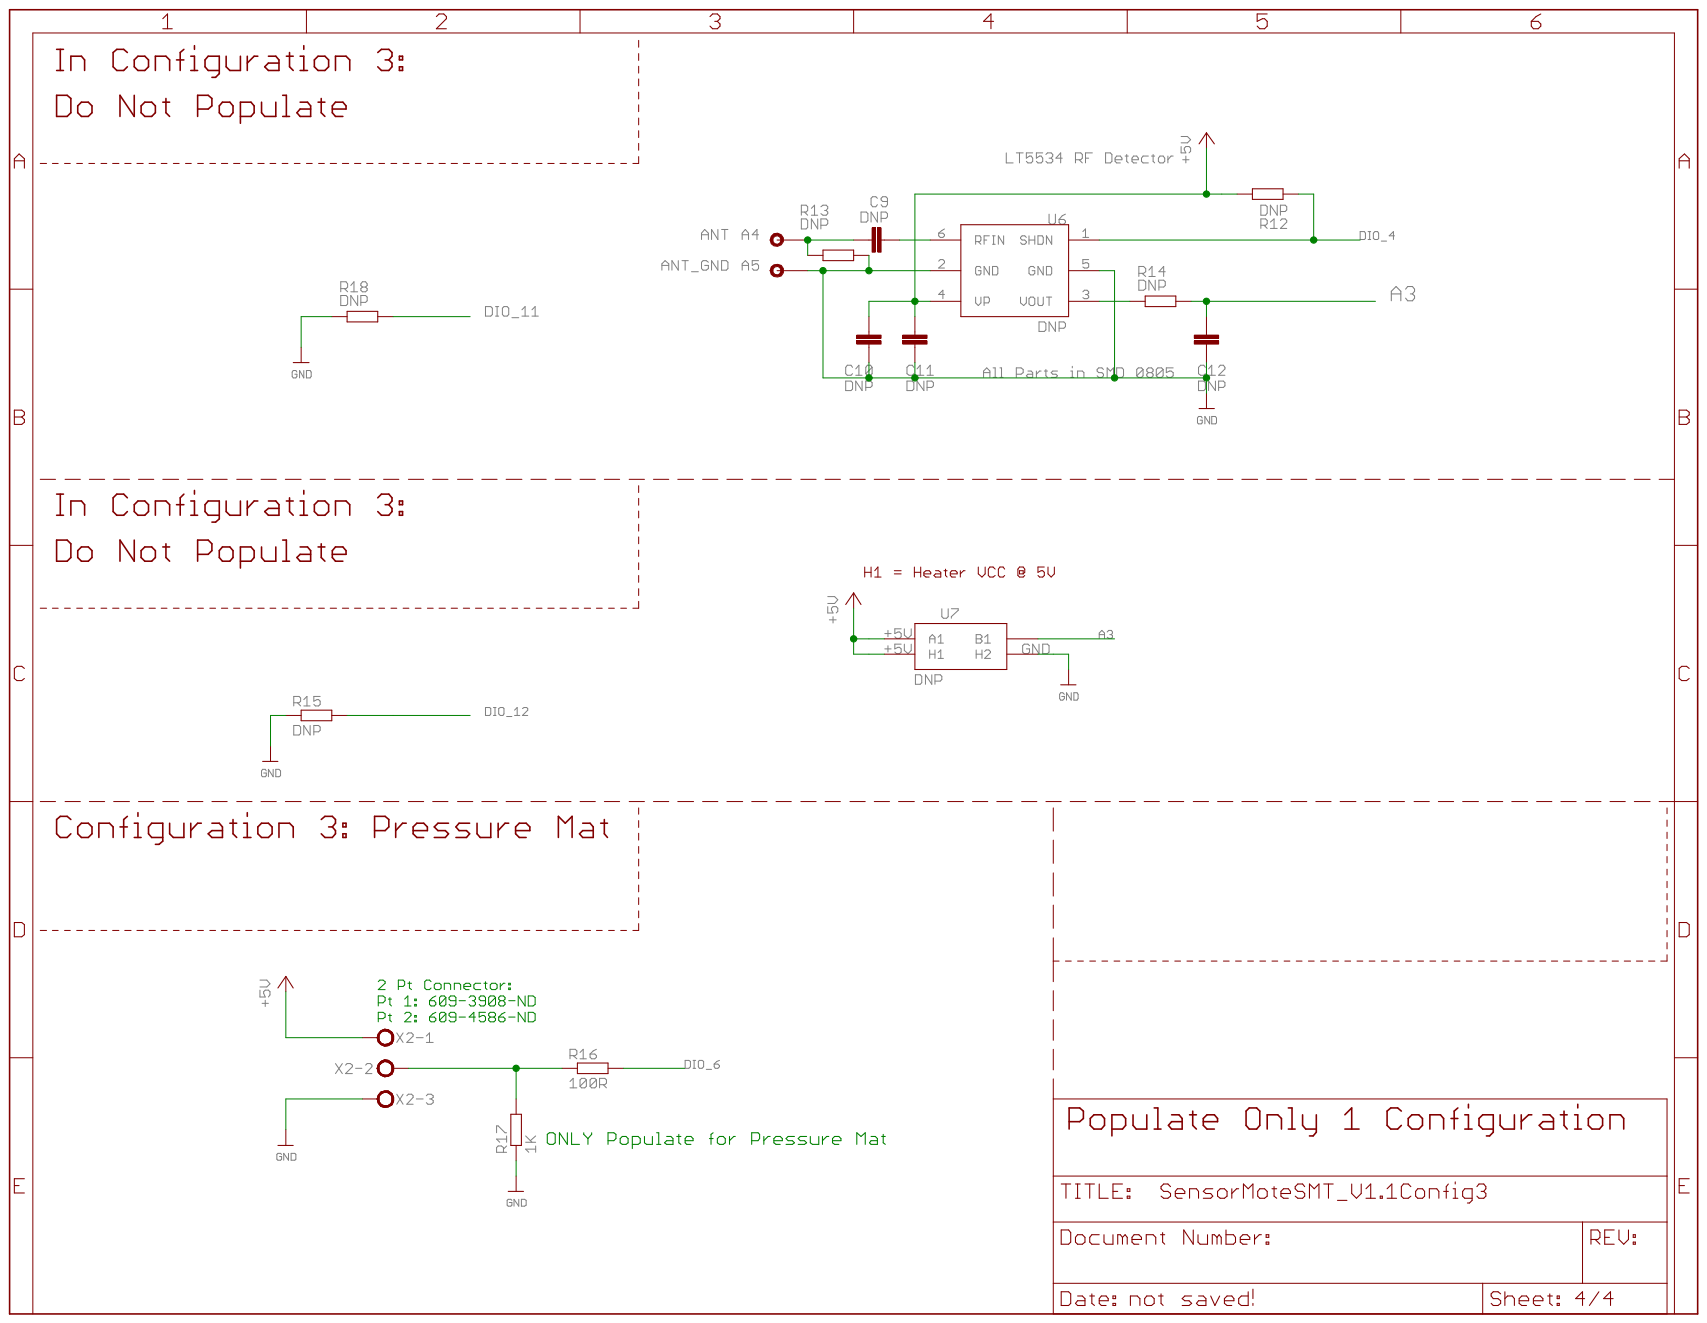
[picture p17: page 1]
