kippkitts/DataSensingLab/DSL_Sensor_Mote/Eagle/SensorMoteSMT_V1.1Config_RF_PCB.pdf

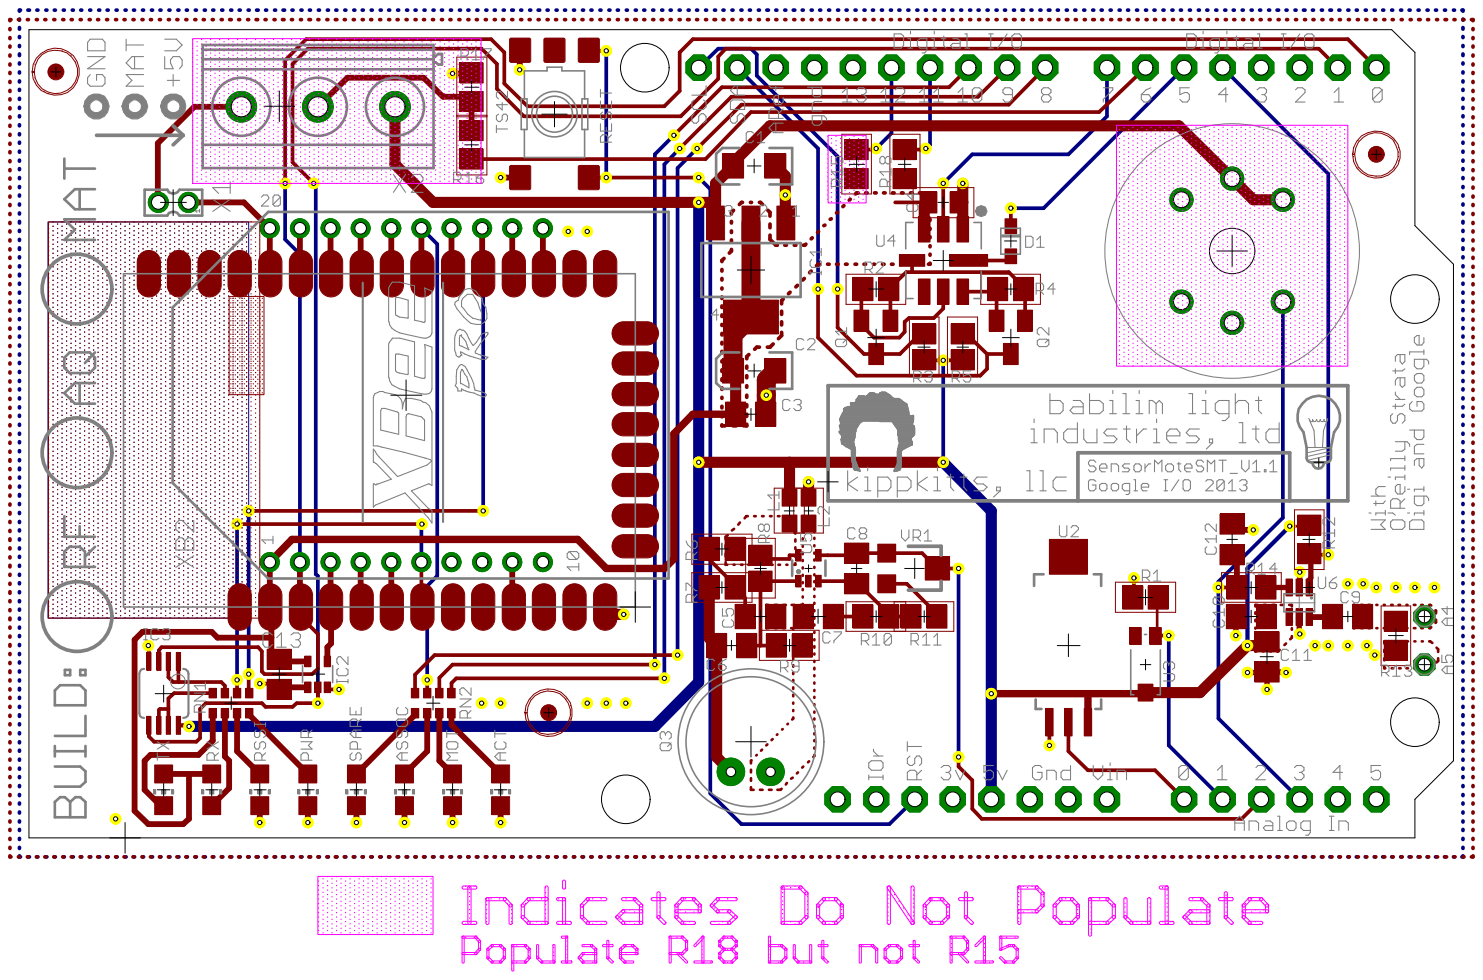
[picture p18: page 1]
