kippkitts/DataSensingLab/ONA_Sensor_Mote/Circuit Board/ONA_SensorMote_V1/ONA_SensorMoteV1.brd

## EAGLE design ONA_Sensor_Mote/Circuit Board/ONA_SensorMote_V1/ONA_SensorMoteV1.brd (2014-08-04)

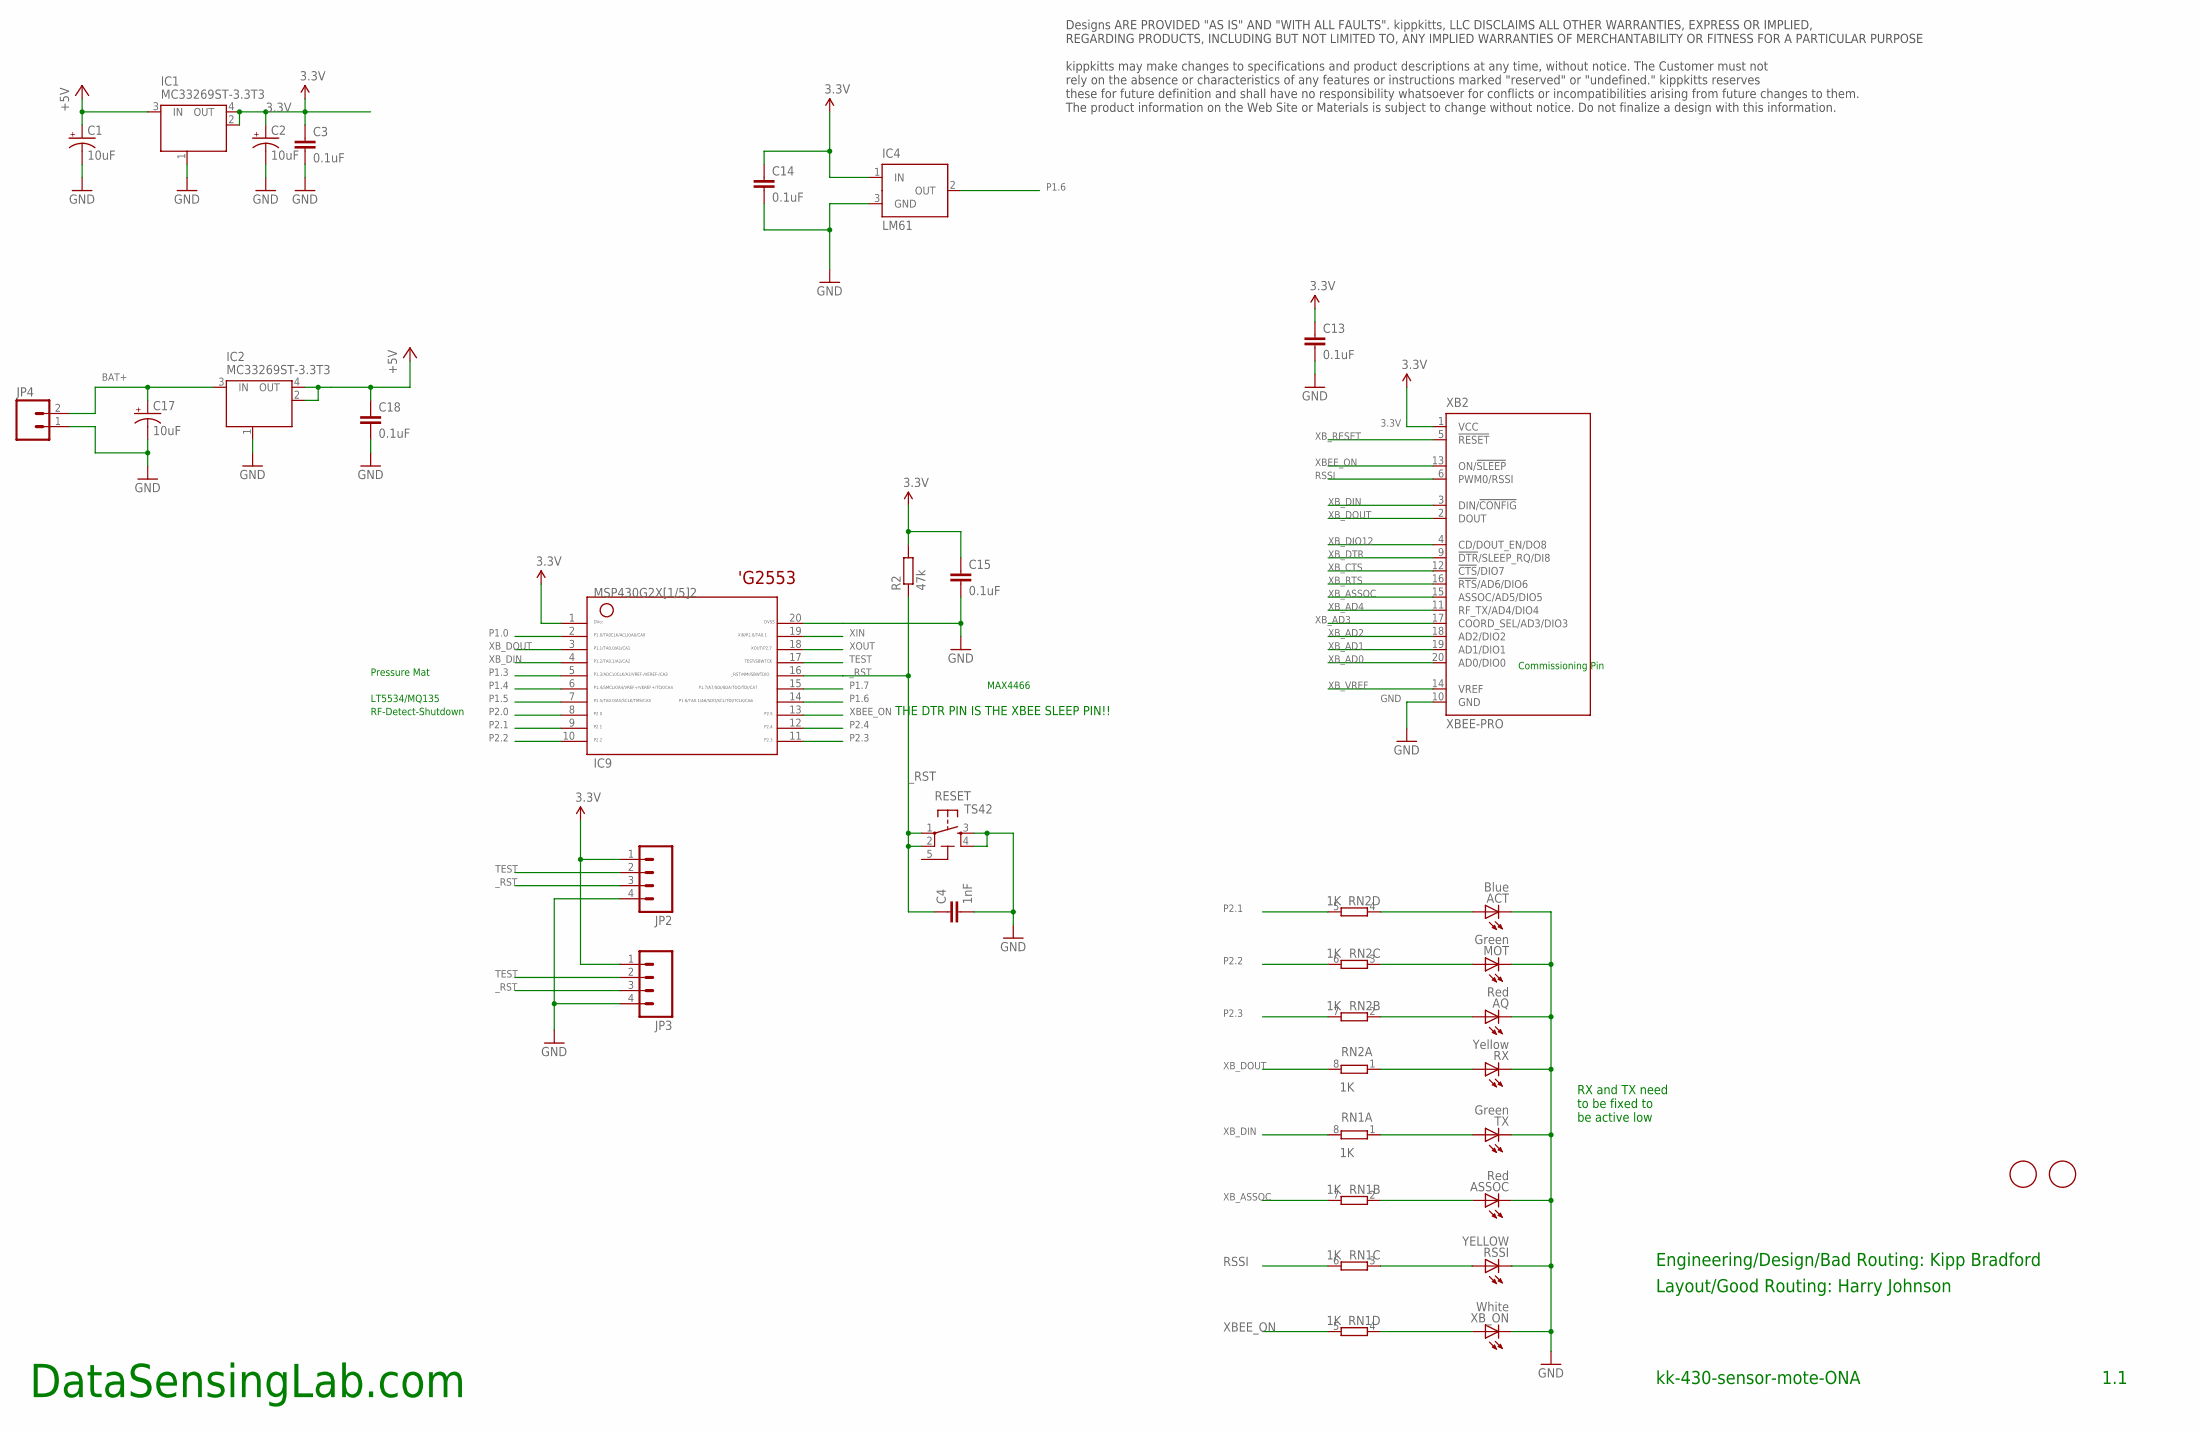
[picture p23: schematic ONA_SensorMoteV1.sch, sheet 1]

Parts:
A1, A2: FIDUCIALMOUNT; FIDUCIA-MOUNT
ACT: Blue; CHIP-LED0805
AQ: Red; CHIP-LED0805
ASSOC: Red; CHIP-LED0805
C1, C2, C17: 10uF; EIA3216
C3, C13, C14, C15, C18: 0.1uF; C0805K
C4: 1nF; C0805K
DISCLAIMER1: DISCLAIMERV1; DISCLAIMER
IC1, IC2: MC33269ST-3.3T3; SOT223
IC4: LM61; SOT23
IC9: G2X[1/5]2---PW20; PW20
JP2: M04SMD; 1X04-SMD
JP3: M04PTH; 1X04
JP4: M02; 1X02_LONGPADS
MOT: Green; CHIP-LED0805
R2: 47k; R0805
RESET: TS42
RN1, RN2: 1K; CAY16
RSSI: YELLOW; CHIP-LED0805
RX: Yellow; CHIP-LED0805
TX: Green; CHIP-LED0805
XB2: XBEE-PRO
XB_ON: White; CHIP-LED0805

Connections:
3.3V: C2.A (+), C3.1, C13.1, C14.1, C15.1, IC1.2 (OUT), IC1.4 (OUT), IC4.1 (IN), IC9.1, JP2.1, JP3.1, R2.2, XB2.1 (VCC); also elsewhere on the board
5-GND: RESET.5 (5-GND)
+5V: C1.A (+), C18.1, IC1.3 (IN), IC2.2 (OUT), IC2.4 (OUT); also elsewhere on the board
BAT+: C17.A (+), IC2.3 (IN), JP4.2
GND: ACT.C, AQ.C, ASSOC.C, C1.C (-), C2.C (-), C3.2, C4.2, C13.2, C14.2, C15.2, C17.C (-), C18.2, IC1.1 (GND/ADJ), IC2.1 (GND/ADJ), IC4.3 (GND), IC9.20, JP2.4, JP3.4, JP4.1, MOT.C, RESET.3, RESET.4, RSSI.C, RX.C, TX.C, XB2.10 (GND), XB_ON.C; also elsewhere on the board
unnamed: RN1.1, TX.A
unnamed: ASSOC.A, RN1.2 (1)
unnamed: ACT.A, RN2.4 (1)
unnamed: MOT.A, RN2.3 (1)
unnamed: RN1.3 (1), RSSI.A
unnamed: AQ.A, RN2.2 (1)
unnamed: RN2.1, RX.A
unnamed: RN1.4 (1), XB_ON.A
P1.0: IC9.2
P1.3: IC9.5; also elsewhere on the board
P1.4: IC9.6; also elsewhere on the board
P1.5: IC9.7; also elsewhere on the board
P1.6: IC4.2 (OUT), IC9.14
P1.7: IC9.15; also elsewhere on the board
P2.0: IC9.8; also elsewhere on the board
P2.1: IC9.9, RN2.5 (2)
P2.2: IC9.10, RN2.6 (2)
P2.3: IC9.11, RN2.7 (2); also elsewhere on the board
P2.4: IC9.12
RSSI: RN1.6 (2), XB2.6 (PWM0/RSSI)
TEST: IC9.17, JP2.2, JP3.2
XBEE_ON: IC9.13, RN1.5 (2), XB2.13 (ON/!SLEEP)
XB_AD0: XB2.20 (AD0/DIO0)
XB_AD1: XB2.19 (AD1/DIO1)
XB_AD2: XB2.18 (AD2/DIO2)
XB_AD3: XB2.17 (COORD_SEL/AD3/DIO3)
XB_AD4: XB2.11 (RF_TX/AD4/DIO4)
XB_ASSOC: RN1.7 (2), XB2.15 (ASSOC/AD5/DIO5)
XB_CTS: XB2.12 (!CTS!/DIO7)
XB_DIN: IC9.4, RN1.8 (2), XB2.3 (DIN/!CONFIG)
XB_DIO12: XB2.4 (CD/DOUT_EN/DO8)
XB_DOUT: IC9.3, RN2.8 (2), XB2.2 (DOUT)
XB_DTR: XB2.9 (!DTR!/SLEEP_RQ/DI8)
XB_RESET: XB2.5 (!RESET)
XB_RTS: XB2.16 (!RTS!/AD6/DIO6)
XB_VREF: XB2.14 (VREF)
XIN: IC9.19
XOUT: IC9.18
_RST: C4.1, IC9.16, JP2.3, JP3.3, R2.1, RESET.1, RESET.2

Notes on the sheet:
Commissioning Pin
MAX4466
LT5534/MQ135
Pressure Mat
RF-Detect-Shutdown
Engineering/Design/Bad Routing: Kipp Bradford
Layout/Good Routing: Harry Johnson
1.1
kk-430-sensor-mote-ONA
DataSensingLab.com
'G2553
RX and TX need to be fixed to be active low
THE DTR PIN IS THE XBEE SLEEP PIN!!

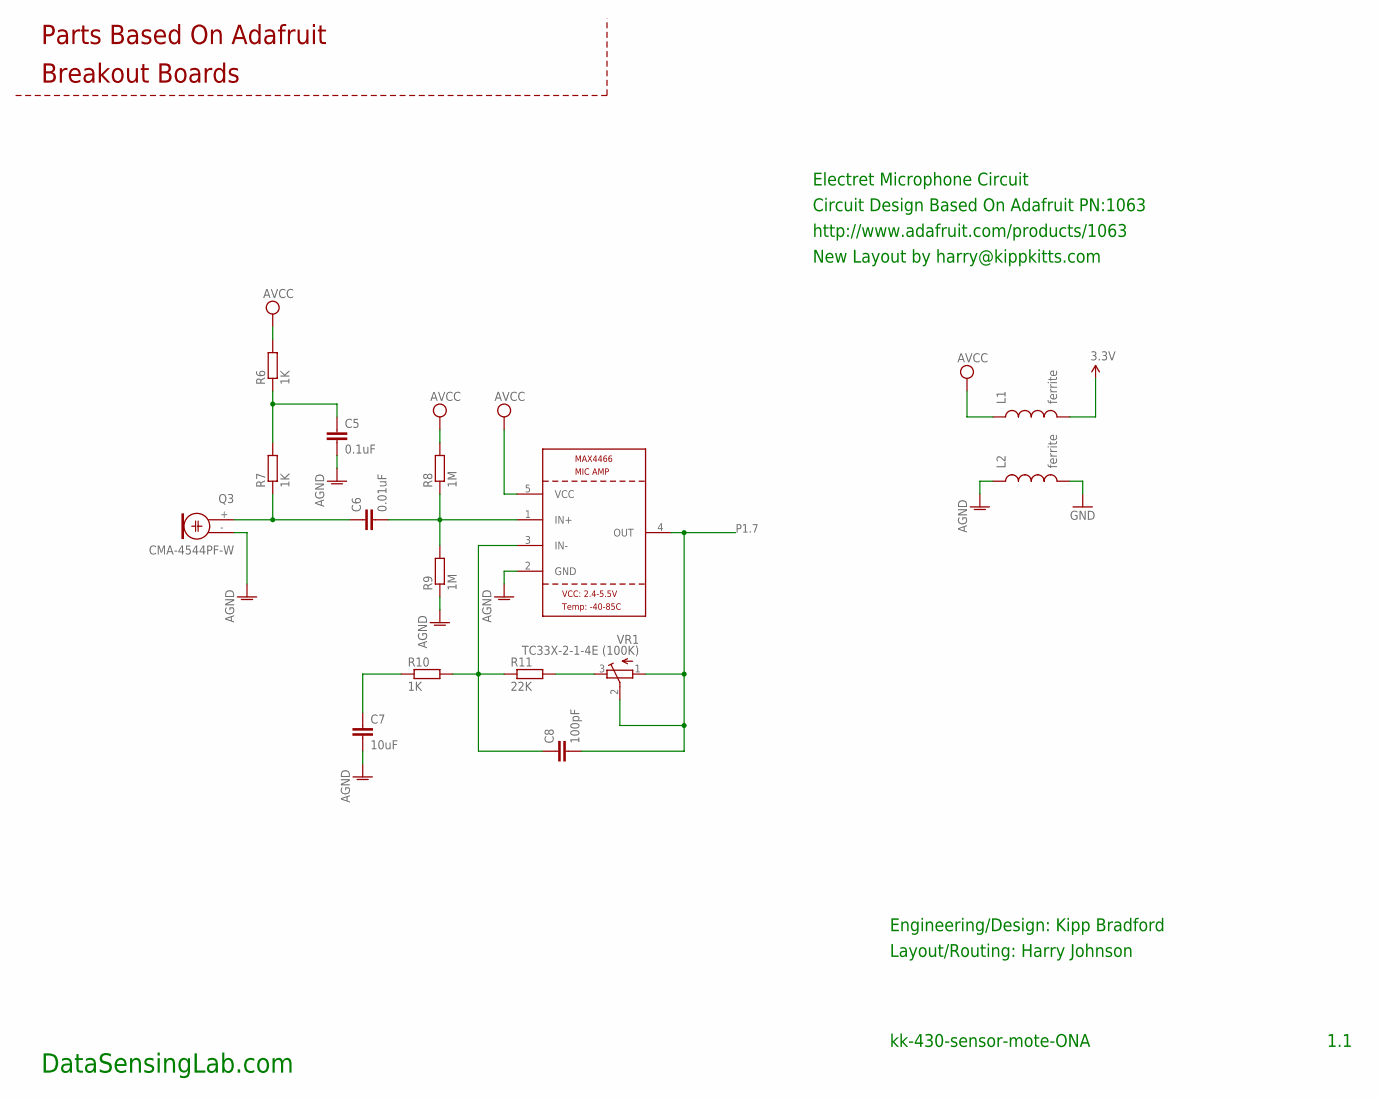
[picture p24: schematic ONA_SensorMoteV1.sch, sheet 2, Adafruit Parts]

Parts:
C5: 0.1uF; C0805K
C6: 0.01uF; C0805K
C7: 10uF; C0805K
C8: 100pF; C0805K
L1, L2: ferrite; 0603
Q3: CMA-4544PF-W; 9.7ELECTRET
R6, R7, R10: 1K; R0805
R8, R9: 1M; R0805
R11: 22K; R0805
U5: MAX4466SC70; SC70-5L
VR1: TC33X-2-1-4E (100K); TC33X

Connections:
3.3V: L1.2; also elsewhere on the board
AGND: C5.2, C7.2, L2.1, Q3.- (1), R9.1, U5.2 (GND)
GND: L2.2; also elsewhere on the board
unnamed: C6.1, Q3.+ (2), R7.1
unnamed: C6.2, R8.1, R9.2, U5.1 (IN+)
unnamed: C5.1, R6.1, R7.2
unnamed: C8.1, R10.2, R11.1, U5.3 (IN-)
unnamed: C7.1, R10.1
unnamed: R11.2, VR1.3 (E)
P1.7: C8.2, U5.4 (OUT), VR1.1 (A), VR1.2 (S); also elsewhere on the board
VCC: L1.1, R6.2, R8.2, U5.5 (VCC)

Notes on the sheet:
Parts Based On Adafruit
Breakout Boards
Circuit Design Based On Adafruit PN:1063
Electret Microphone Circuit
http://www.adafruit.com/products/1063
New Layout by harry@kippkitts.com
Engineering/Design: Kipp Bradford
Layout/Routing: Harry Johnson
1.1
kk-430-sensor-mote-ONA
DataSensingLab.com

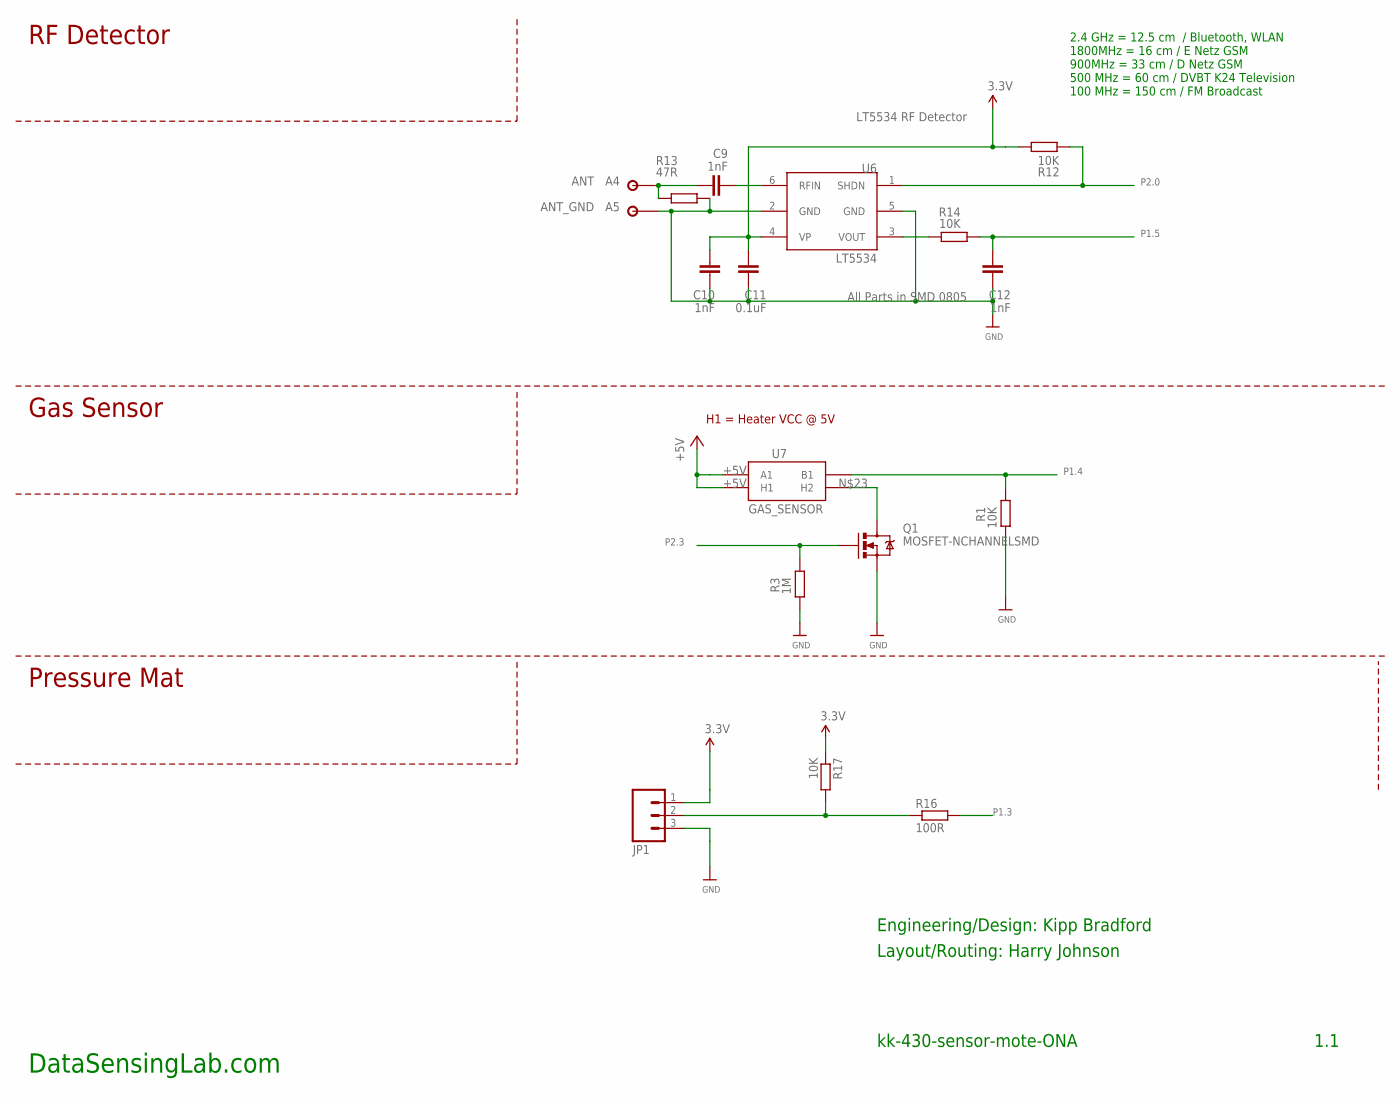
[picture p25: schematic ONA_SensorMoteV1.sch, sheet 3, Other_Sensors]

Parts:
A4: ANT; PAD146
A5: ANT_GND; PAD146
C9, C10, C12: 1nF; C0805K
C11: 0.1uF; C0805K
JP1: M03LOCK; 1X03_LOCK
Q1: MOSFET-NCHANNELSMD; SOT23-3
R1, R12, R14, R17: 10K; R0805
R3: 1M; R0805
R13: 47R; R0805
R16: 100R; R0805
U6: LT5534; SC70
U7: GAS_SENSOR; MQ-3

Connections:
3.3V: C10.2, C11.2, JP1.1, R12.2, R17.1, U6.4 (VP); also elsewhere on the board
+5V: U7.A1, U7.HA (H1); also elsewhere on the board
GND: A5.1, C10.1, C11.1, C12.1, JP1.3, Q1.2 (S), R1.1, R3.1, R13.2, U6.2 (GND), U6.5 (GND); also elsewhere on the board
unnamed: C9.1, U6.6 (RFIN)
unnamed: A4.1, C9.2, R13.1
unnamed: R14.1, U6.3 (VOUT)
unnamed: JP1.2, R16.1, R17.2
unnamed: Q1.3 (D), U7.HB (H2)
P1.3: R16.2; also elsewhere on the board
P1.4: R1.2, U7.B1; also elsewhere on the board
P1.5: C12.2, R14.2; also elsewhere on the board
P2.0: R12.1, U6.1 (SHDN); also elsewhere on the board
P2.3: Q1.1 (G), R3.2; also elsewhere on the board

Notes on the sheet:
All Parts in SMD 0805
LT5534 RF Detector
H1 = Heater VCC @ 5V
Pressure Mat
Gas Sensor
RF Detector
Engineering/Design: Kipp Bradford
Layout/Routing: Harry Johnson
1.1
kk-430-sensor-mote-ONA
DataSensingLab.com
2.4 GHz = 12.5 cm / Bluetooth, WLAN 1800MHz = 16 cm / E Netz GSM 900MHz = 33 cm / D Netz GSM 500 MHz = 60 cm / DVBT K24 Television 100 MHz = 150 cm / FM Broadcast

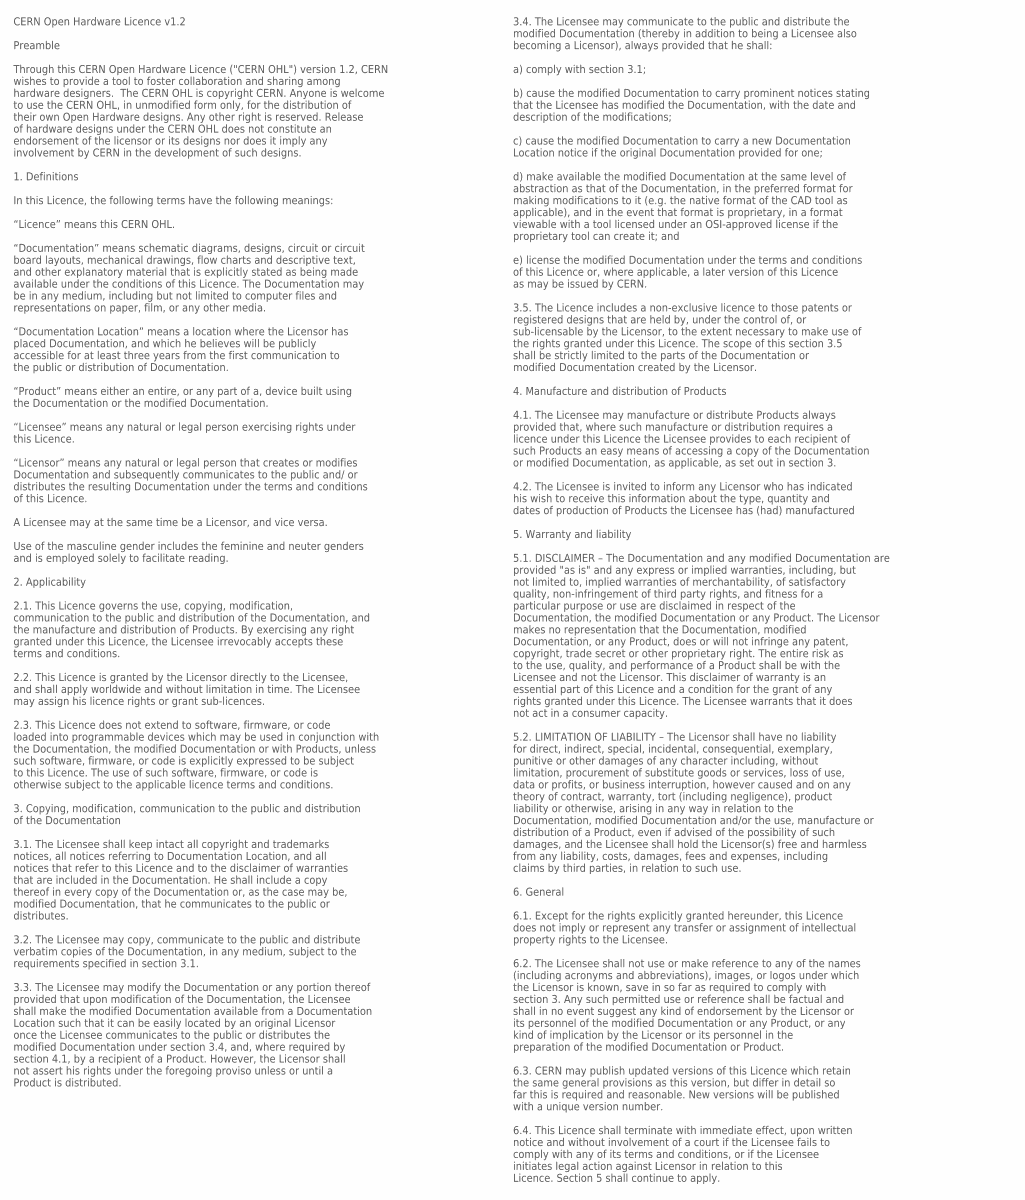
[picture p26: schematic ONA_SensorMoteV1.sch, sheet 4, Licensce]

Notes on the sheet:
CERN Open Hardware Licence v1.2 Preamble Through this CERN Open Hardware Licence ("CERN OHL") version 1.2, CERN wishes to provide a tool to foster collaboration and sharing among hardware designers. The CERN OHL is copyright CERN. Anyone is welcome to use the CERN OHL, in unmodified form only, for 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
3.4. The Licensee may communicate to the public and distribute the modified Documentation (thereby in addition to being a Licensee also becoming a Licensor), always provided that he shall: a) comply with section 3.1; b) cause the modified Documentation to carry prominent notices stating that the Li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

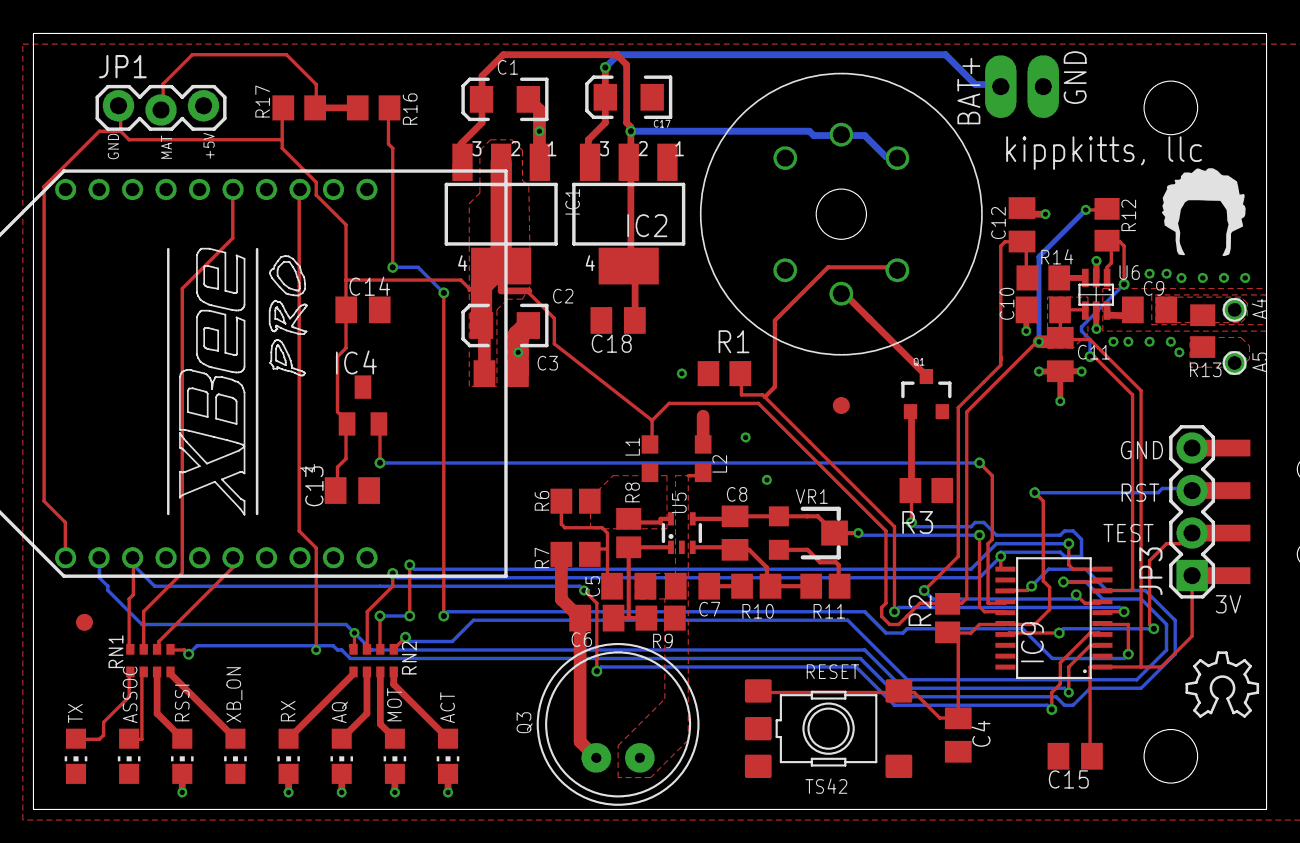
[picture p27: board ONA_SensorMoteV1.brd from above]

Board: 2 copper layers, 73.7 x 46.4 mm, 66 parts (0 on the bottom side), 41 nets.

Other parts of the board:
U$3: OSHW_6X150_NOTEXT
U$5: TOP_DOCU_5MM
