kippkitts/DataSensingLab/DSL_Sensor_Mote/Eagle/SensorMoteSMT_V1.1MCAD.brd

## EAGLE design DSL_Sensor_Mote/Eagle/SensorMoteSMT_V1.1MCAD.brd (2014-03-26)

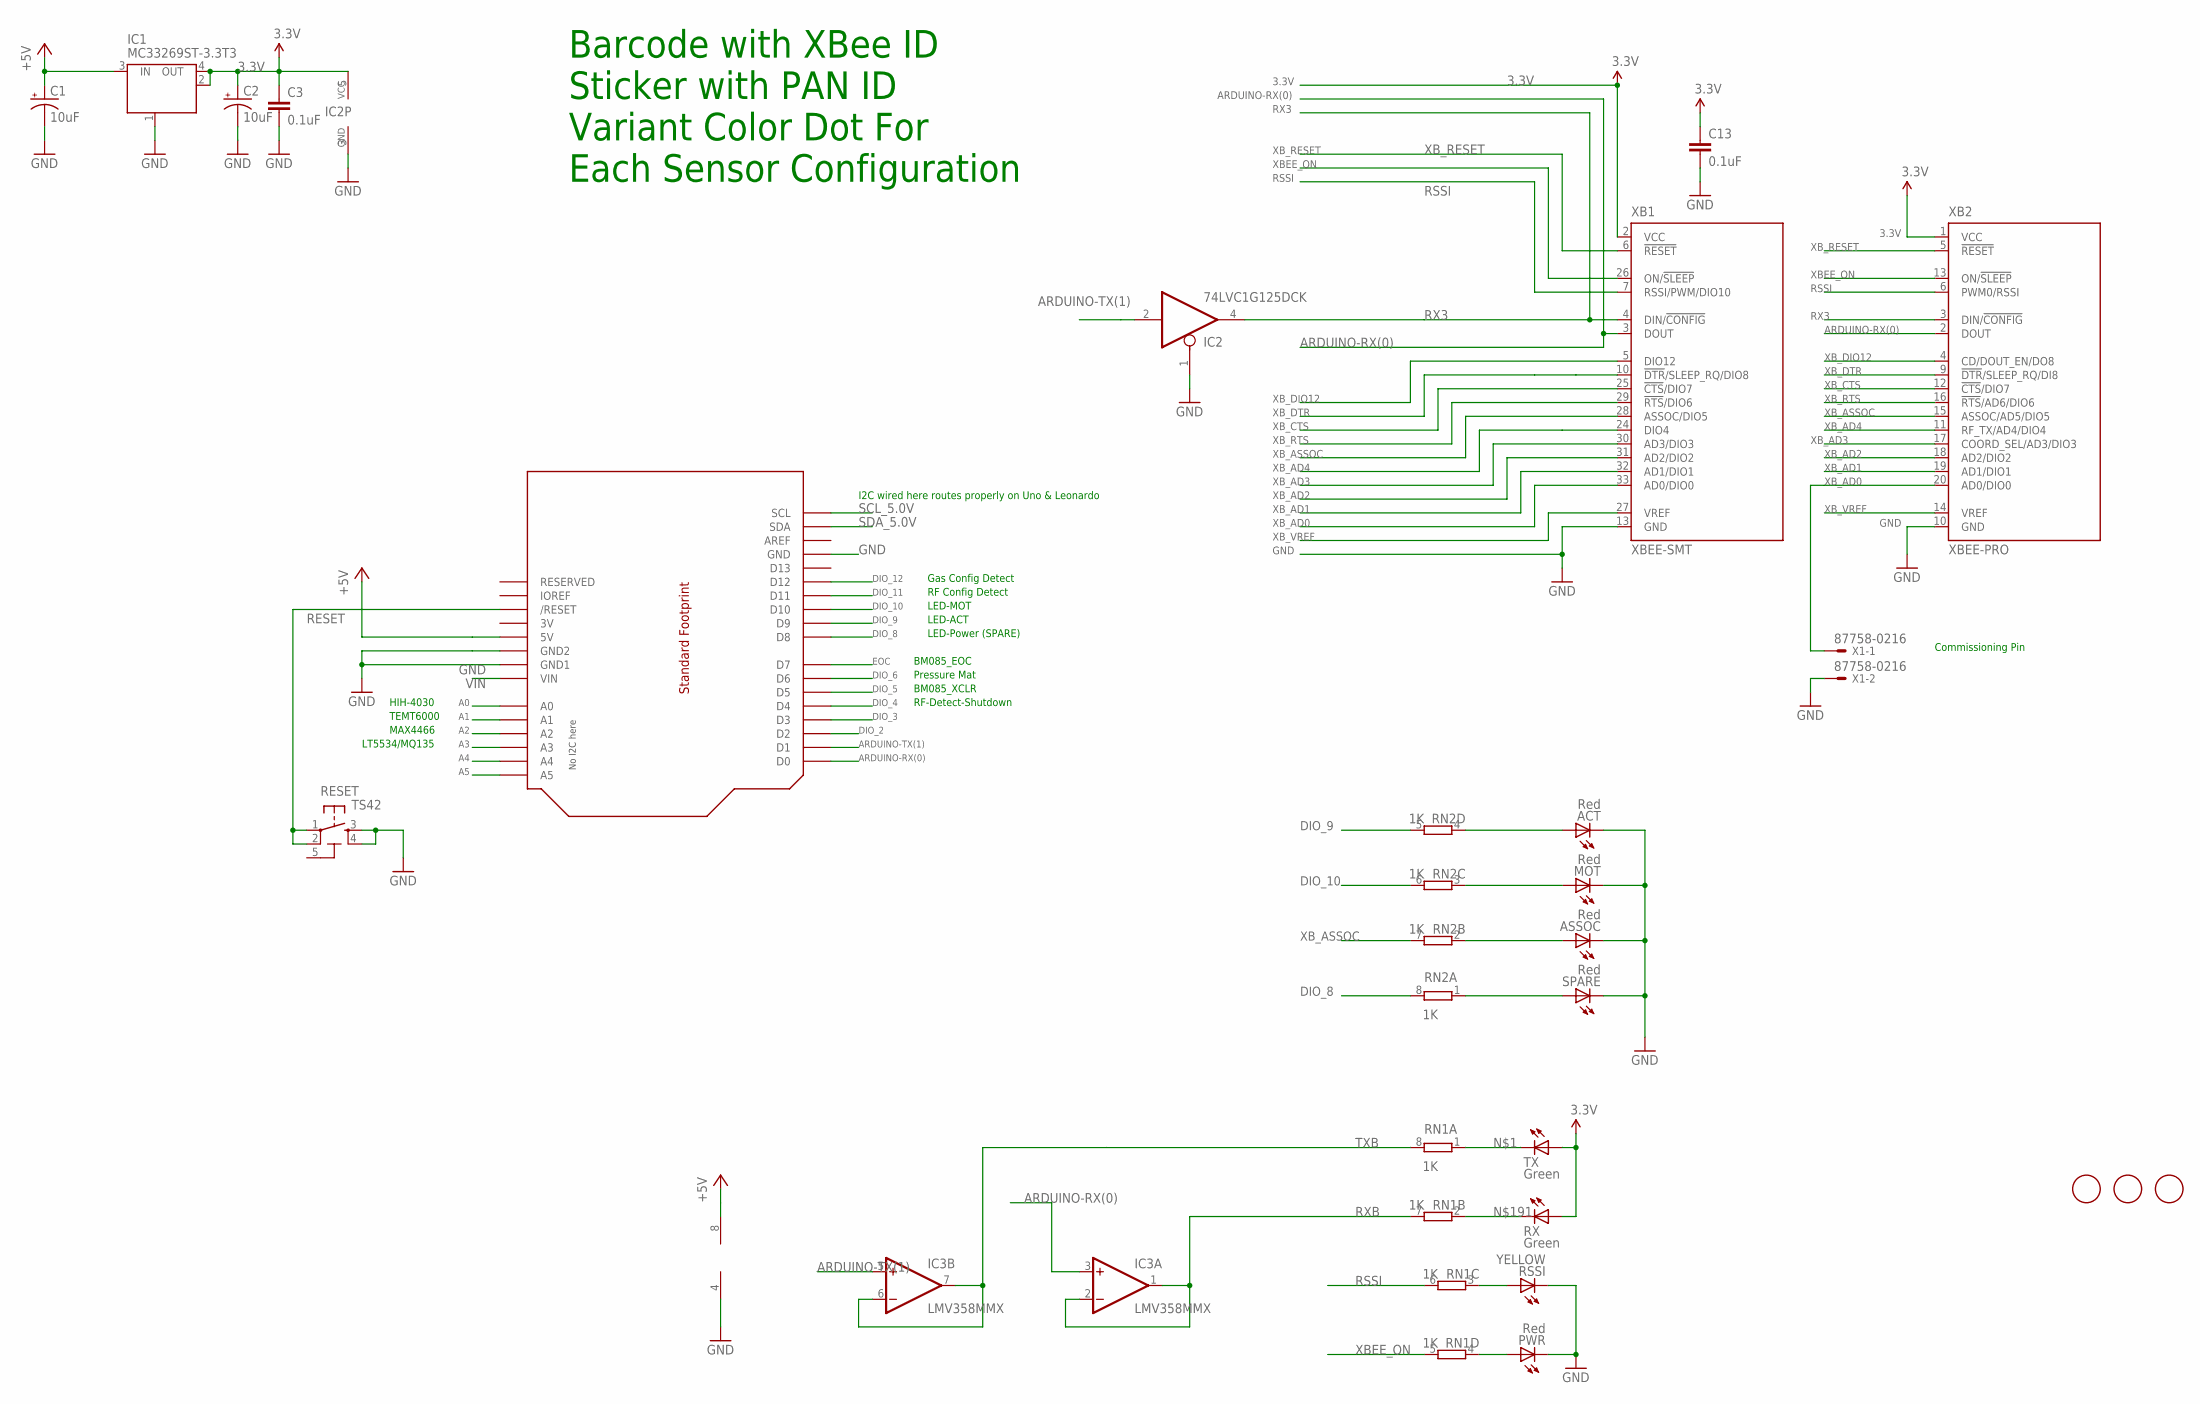
[picture p28: schematic SensorMoteSMT_V1.1MCAD.sch, sheet 1]

Parts:
A1, A2, A3: FIDUCIALMOUNT; FIDUCIA-MOUNT
ACT: Red; CHIP-LED0805
ASSOC: Red; CHIP-LED0805
C1, C2: 10uF; EIA3216
C3, C13: 0.1uF; C0805K
IC1: MC33269ST-3.3T3; SOT223
IC2: 74LVC1G125DCK; SC70-5
IC3: LMV358MMX; MSOP08
MOT: Red; CHIP-LED0805
PWR: Red; CHIP-LED0805
RESET: TS42
RN1, RN2: 1K; CAY16
RSSI: YELLOW; CHIP-LED0805
RX: Green; CHIP-LED0805
SPARE: Red; CHIP-LED0805
TX: Green; CHIP-LED0805
U1: ARDUINOR3; ARDUINOR3_EXTENDED
X1: 87758-0216
XB1: XBEE-SMT
XB2: XBEE-PRO

Connections:
3.3V: C2.A (+), C3.1, C13.1, IC1.2 (OUT), IC1.4 (OUT), IC2.5 (VCC), RX.A, TX.A, XB1.2 (VCC), XB2.1 (VCC); also elsewhere on the board
3V: U1.3V
5-GND: RESET.5 (5-GND)
+5V: C1.A (+), IC1.3 (IN), IC3.8 (V+), U1.5V; also elsewhere on the board
A0: U1.A0; also elsewhere on the board
A1: U1.A1; also elsewhere on the board
A2: U1.A2; also elsewhere on the board
A3: U1.A3; also elsewhere on the board
A4: U1.A4
A5: U1.A5
ARDUINO-RX(0): IC3.3 (+IN), U1.D0, XB1.3 (DOUT), XB2.2 (DOUT)
ARDUINO-TX(1): IC2.2 (I), IC3.5 (+IN), U1.D1
DIO_2: U1.D2
DIO_3: U1.D3
DIO_4: U1.D4; also elsewhere on the board
DIO_5: U1.D5; also elsewhere on the board
DIO_6: U1.D6; also elsewhere on the board
DIO_8: RN2.8 (2), U1.D8
DIO_9: RN2.5 (2), U1.D9
DIO_10: RN2.6 (2), U1.D10
DIO_11: U1.D11; also elsewhere on the board
DIO_12: U1.D12; also elsewhere on the board
EOC: U1.D7; also elsewhere on the board
GND: ACT.C, ASSOC.C, C1.C (-), C2.C (-), C3.2, C13.2, IC1.1 (GND/ADJ), IC2.1 (OE), IC2.3 (GND), IC3.4 (V-), MOT.C, PWR.C, RESET.3, RESET.4, RSSI.C, SPARE.C, U1.GND, U1.GND1, U1.GND2, X1.2, XB1.13 (GND), XB2.10 (GND); also elsewhere on the board
unnamed: RN1.1, TX.C
unnamed: ACT.A, RN2.4 (1)
unnamed: MOT.A, RN2.3 (1)
unnamed: RN1.3 (1), RSSI.A
unnamed: ASSOC.A, RN2.2 (1)
unnamed: RN2.1, SPARE.A
unnamed: PWR.A, RN1.4 (1)
unnamed: RN1.2 (1), RX.C
RESET: RESET.1, RESET.2, U1.RESET (/RESET)
RSSI: RN1.6 (2), XB1.7 (RSSI/PWM/DIO10), XB2.6 (PWM0/RSSI)
RX3: IC2.4 (O), XB1.4 (DIN/!CONFIG), XB2.3 (DIN/!CONFIG)
RXB: IC3.1 (OUT), IC3.2 (-IN), RN1.7 (2)
SCL_5.0V: U1.SCL; also elsewhere on the board
SDA_5.0V: U1.SDA; also elsewhere on the board
TXB: IC3.6 (-IN), IC3.7 (OUT), RN1.8 (2)
VIN: U1.VIN
XBEE_ON: RN1.5 (2), XB1.26 (ON/!SLEEP), XB2.13 (ON/!SLEEP)
XB_AD0: X1.1, XB1.33 (AD0/DIO0), XB2.20 (AD0/DIO0)
XB_AD1: XB1.32 (AD1/DIO1), XB2.19 (AD1/DIO1)
XB_AD2: XB1.31 (AD2/DIO2), XB2.18 (AD2/DIO2)
XB_AD3: XB1.30 (AD3/DIO3), XB2.17 (COORD_SEL/AD3/DIO3)
XB_AD4: XB1.24 (DIO4), XB2.11 (RF_TX/AD4/DIO4)
XB_ASSOC: RN2.7 (2), XB1.28 (ASSOC/DIO5), XB2.15 (ASSOC/AD5/DIO5)
XB_CTS: XB1.25 (!CTS!/DIO7), XB2.12 (!CTS!/DIO7)
XB_DIO12: XB1.5 (DIO12), XB2.4 (CD/DOUT_EN/DO8)
XB_DTR: XB1.10 (!DTR!/SLEEP_RQ/DIO8), XB2.9 (!DTR!/SLEEP_RQ/DI8)
XB_RESET: XB1.6 (!RESET), XB2.5 (!RESET)
XB_RTS: XB1.29 (!RTS!/DIO6), XB2.16 (!RTS!/AD6/DIO6)
XB_VREF: XB1.27 (VREF), XB2.14 (VREF)

Notes on the sheet:
Barcode with XBee ID
Each Sensor Configuration
Variant Color Dot For
Sticker with PAN ID
Commissioning Pin
HIH-4030
TEMT6000
MAX4466
LT5534/MQ135
I2C wired here routes properly on Uno & Leonardo
LED-MOT
LED-ACT
LED-Power (SPARE)
Pressure Mat
RF-Detect-Shutdown
Gas Config Detect
RF Config Detect
BM085_XCLR
BM085_EOC

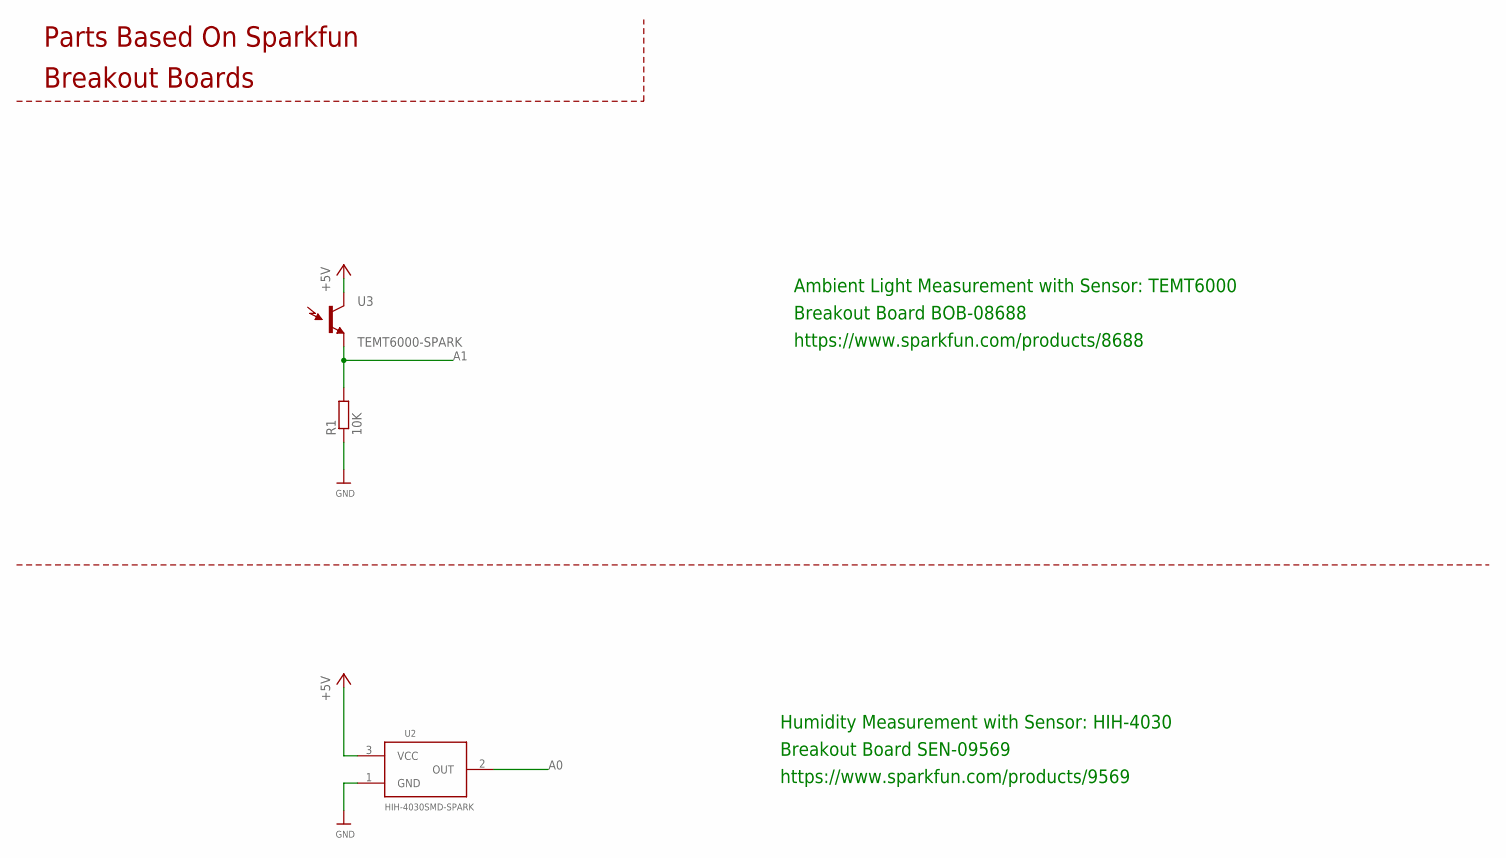
[picture p29: schematic SensorMoteSMT_V1.1MCAD.sch, sheet 2, Sparkfun Parts]

Parts:
R1: 10K; R0805
U2: HIH-4030SMD-SPARK; HIH-4030
U3: TEMT6000-SPARK; TEMT6000-SEN

Connections:
+5V: U2.3 (VCC), U3.COLLECTOR (C1); also elsewhere on the board
A0: U2.2 (OUT); also elsewhere on the board
A1: R1.2, U3.EMITTER (E1); also elsewhere on the board
GND: R1.1, U2.1 (GND); also elsewhere on the board

Notes on the sheet:
Parts Based On Sparkfun
Breakout Boards
Breakout Board SEN-09569
Humidity Measurement with Sensor: HIH-4030
https://www.sparkfun.com/products/9569
Breakout Board BOB-08688
Ambient Light Measurement with Sensor: TEMT6000
https://www.sparkfun.com/products/8688

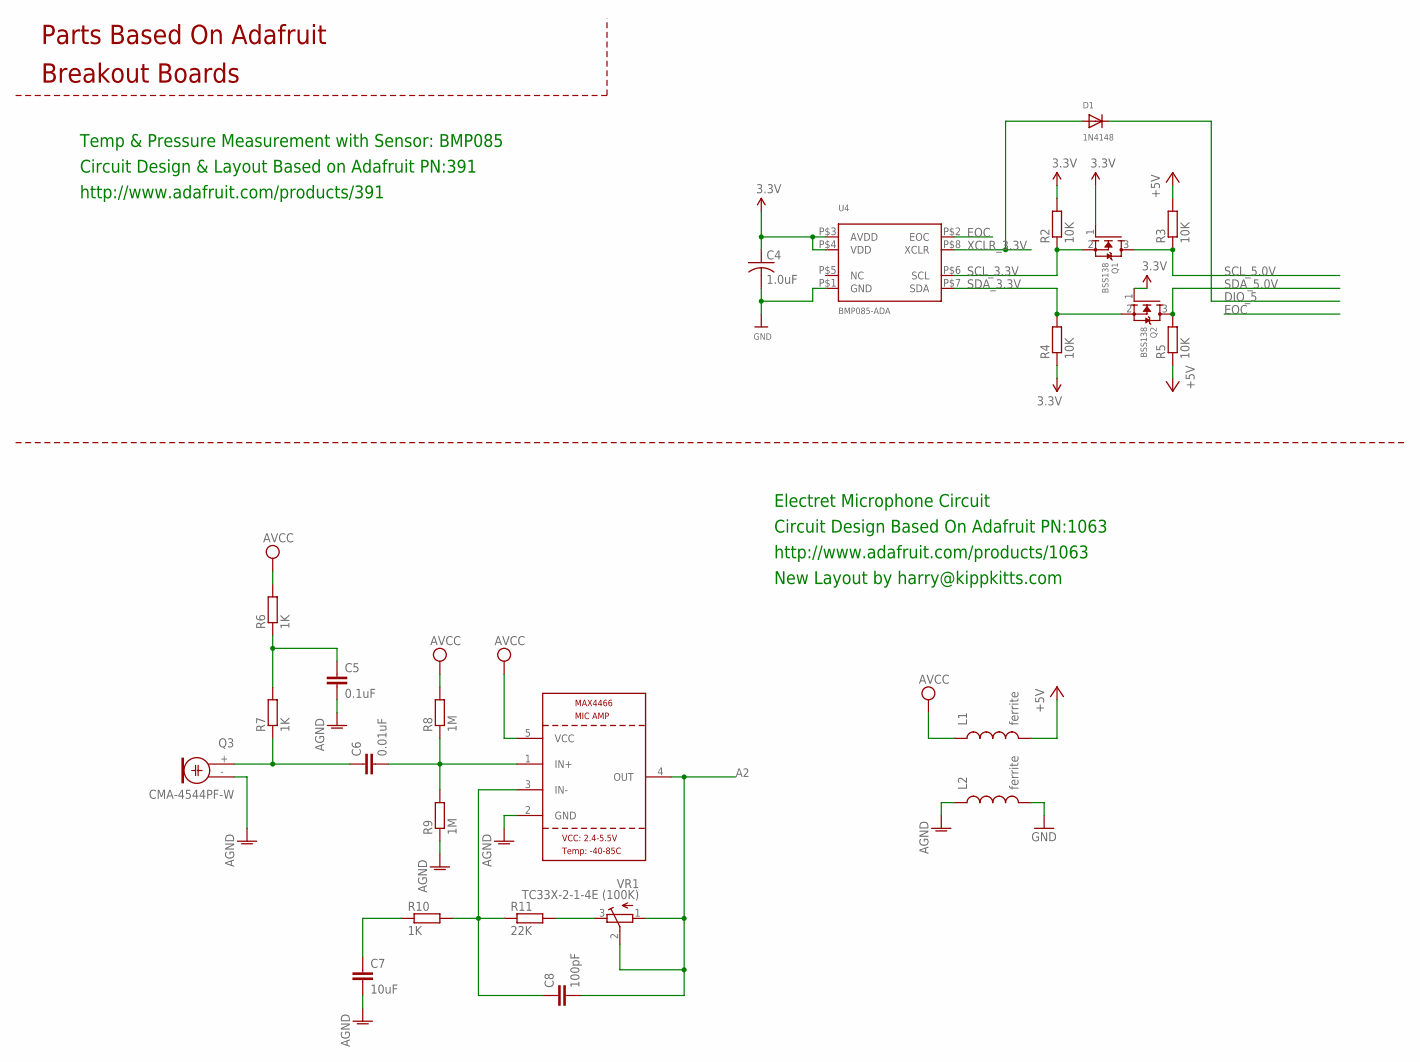
[picture p30: schematic SensorMoteSMT_V1.1MCAD.sch, sheet 3, Adafruit Parts]

Parts:
C4: 1.0uF; C0805K
C5: 0.1uF; C0805K
C6: 0.01uF; C0805K
C7: 10uF; C0805K
C8: 100pF; C0805K
D1: 1N4148; SOD-323F
L1, L2: ferrite; 0603
Q1, Q2: BSS138; SOT23
Q3: CMA-4544PF-W; 9.7ELECTRET
R2, R3, R4, R5: 10K; R0805
R6, R7, R10: 1K; R0805
R8, R9: 1M; R0805
R11: 22K; R0805
U4: BMP085-ADA; BMP085
U5: MAX4466SC70; SC70-5L
VR1: TC33X-2-1-4E (100K); TC33X

Connections:
3.3V: C4.1, Q1.1 (G), Q2.1 (G), R2.2, R4.1, U4.P$3 (AVDD), U4.P$4 (VDD); also elsewhere on the board
+5V: L1.2, R3.2, R5.1; also elsewhere on the board
A2: C8.2, U5.4 (OUT), VR1.1 (A), VR1.2 (S); also elsewhere on the board
AGND: C5.2, C7.2, L2.1, Q3.- (1), R9.1, U5.2 (GND)
DIO_5: D1.C; also elsewhere on the board
EOC: U4.P$2 (EOC); also elsewhere on the board
GND: C4.2, L2.2, U4.P$1 (GND); also elsewhere on the board
unnamed: C6.1, Q3.+ (2), R7.1
unnamed: C6.2, R8.1, R9.2, U5.1 (IN+)
unnamed: C5.1, R6.1, R7.2
unnamed: C8.1, R10.2, R11.1, U5.3 (IN-)
unnamed: C7.1, R10.1
unnamed: R11.2, VR1.3 (E)
SCL_3.3V: Q1.2 (S), R2.1, U4.P$6 (SCL)
SCL_5.0V: Q1.3 (D), R3.1; also elsewhere on the board
SDA_3.3V: Q2.2 (S), R4.2, U4.P$7 (SDA)
SDA_5.0V: Q2.3 (D), R5.2; also elsewhere on the board
VCC: L1.1, R6.2, R8.2, U5.5 (VCC)
XCLR_3.3V: D1.A, U4.P$8 (XCLR)

Notes on the sheet:
Circuit Design & Layout Based on Adafruit PN:391
Parts Based On Adafruit
Breakout Boards
Temp & Pressure Measurement with Sensor: BMP085
http://www.adafruit.com/products/391
Circuit Design Based On Adafruit PN:1063
Electret Microphone Circuit
http://www.adafruit.com/products/1063
New Layout by harry@kippkitts.com

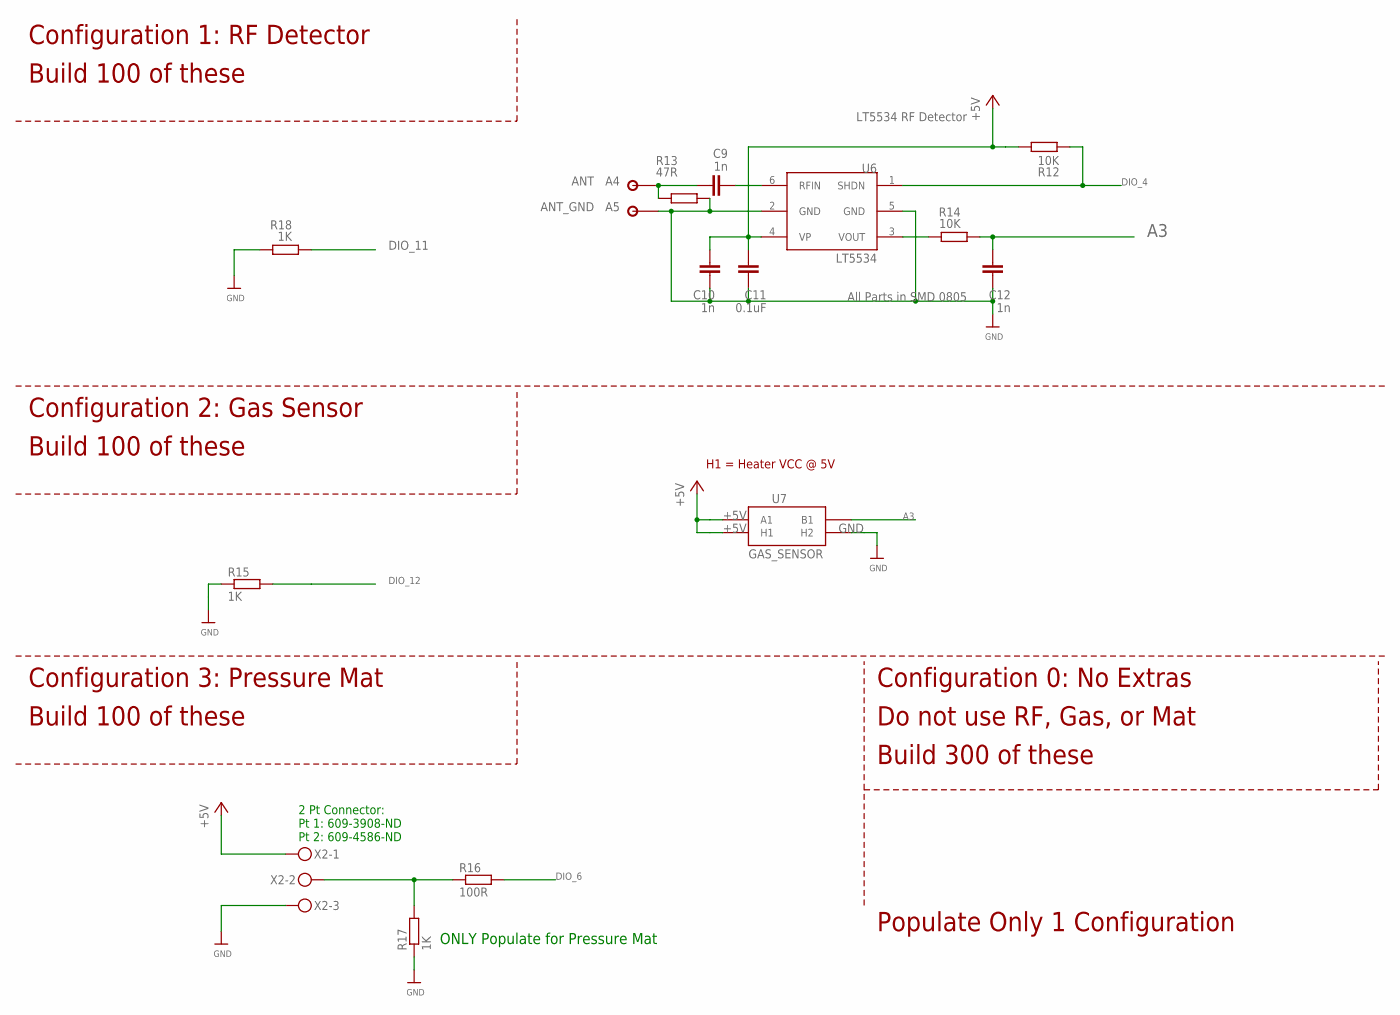
[picture p31: schematic SensorMoteSMT_V1.1MCAD.sch, sheet 4, Other_Sensors]

Parts:
A4: ANT; PAD146
A5: ANT_GND; PAD146
C9, C10, C12: 1n; C0805K
C11: 0.1uF; C0805K
R12, R14: 10K; R0805
R13: 47R; R0805
R15, R17, R18: 1K; R0805
R16: 100R; R0805
U6: LT5534; SC70
U7: GAS_SENSOR; MQ-3
X2: MKDSN1,5/3-5,08

Connections:
+5V: C10.2, C11.2, R12.2, U6.4 (VP), U7.A1, U7.HA (H1), X2.1; also elsewhere on the board
A3: C12.2, R14.2, U7.B1; also elsewhere on the board
DIO_4: R12.1, U6.1 (SHDN); also elsewhere on the board
DIO_6: R16.2; also elsewhere on the board
DIO_11: R18.2; also elsewhere on the board
DIO_12: R15.2; also elsewhere on the board
GND: A5.1, C10.1, C11.1, C12.1, R13.2, R15.1, R17.1, R18.1, U6.2 (GND), U6.5 (GND), U7.HB (H2), X2.3; also elsewhere on the board
unnamed: C9.1, U6.6 (RFIN)
unnamed: A4.1, C9.2, R13.1
unnamed: R14.1, U6.3 (VOUT)
unnamed: R16.1, R17.2, X2.2

Notes on the sheet:
All Parts in SMD 0805
LT5534 RF Detector
H1 = Heater VCC @ 5V
ONLY Populate for Pressure Mat
2 Pt Connector: Pt 1: 609-3908-ND Pt 2: 609-4586-ND
Configuration 3: Pressure Mat
Configuration 0: No Extras
Build 100 of these
Build 300 of these
Do not use RF, Gas, or Mat
Configuration 2: Gas Sensor
Configuration 1: RF Detector
Populate Only 1 Configuration
