kippkitts/DataSensingLab/DSL_Sensor_Mote/Eagle/SensorMoteSMT_V1.1MCAD.brd

## EAGLE design DSL_Sensor_Mote/Eagle/SensorMoteSMT_V1.1MCAD.brd (continued)

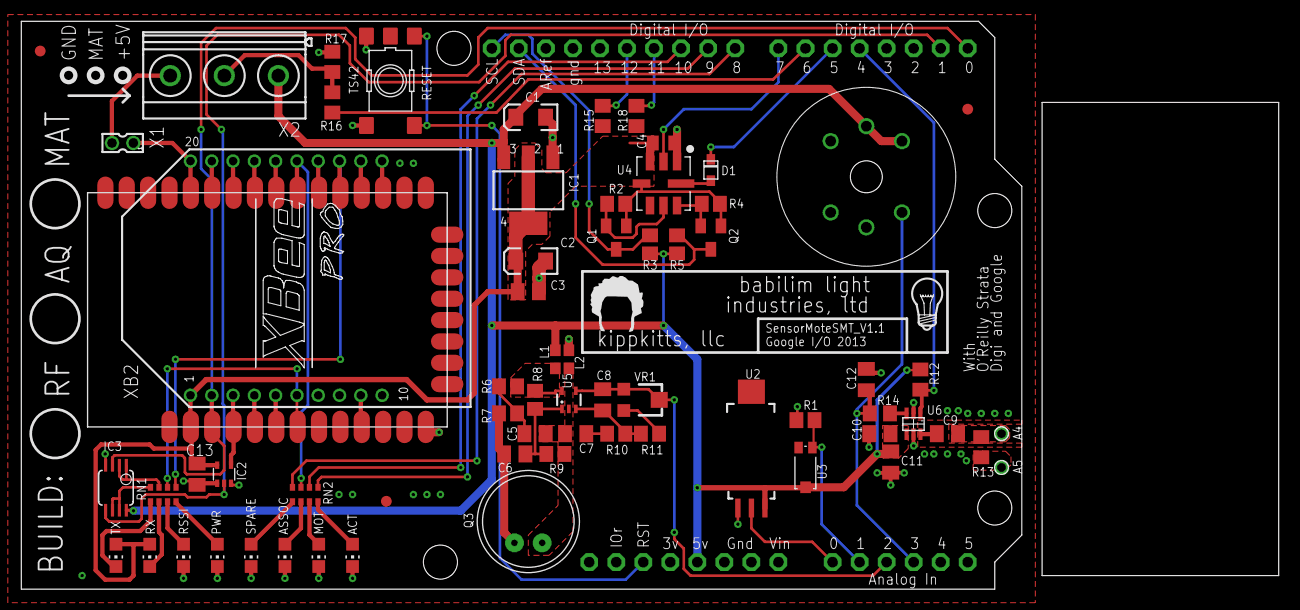
[picture p32: board SensorMoteSMT_V1.1MCAD.brd from above]

Board: 2 copper layers, 118.1 x 53.3 mm, 70 parts (0 on the bottom side), 61 nets.

Other parts of the board:
U$5: TOP_DOCU_5MM
U$7: BABILIM_7.5MM
