kippkitts/DataSensingLab/SensorMoteWorkshop/Eagle/sensing_lab_shield_1-5-1.brd

## EAGLE design SensorMoteWorkshop/Eagle/sensing_lab_shield_1-5-1.brd (2013-09-24)

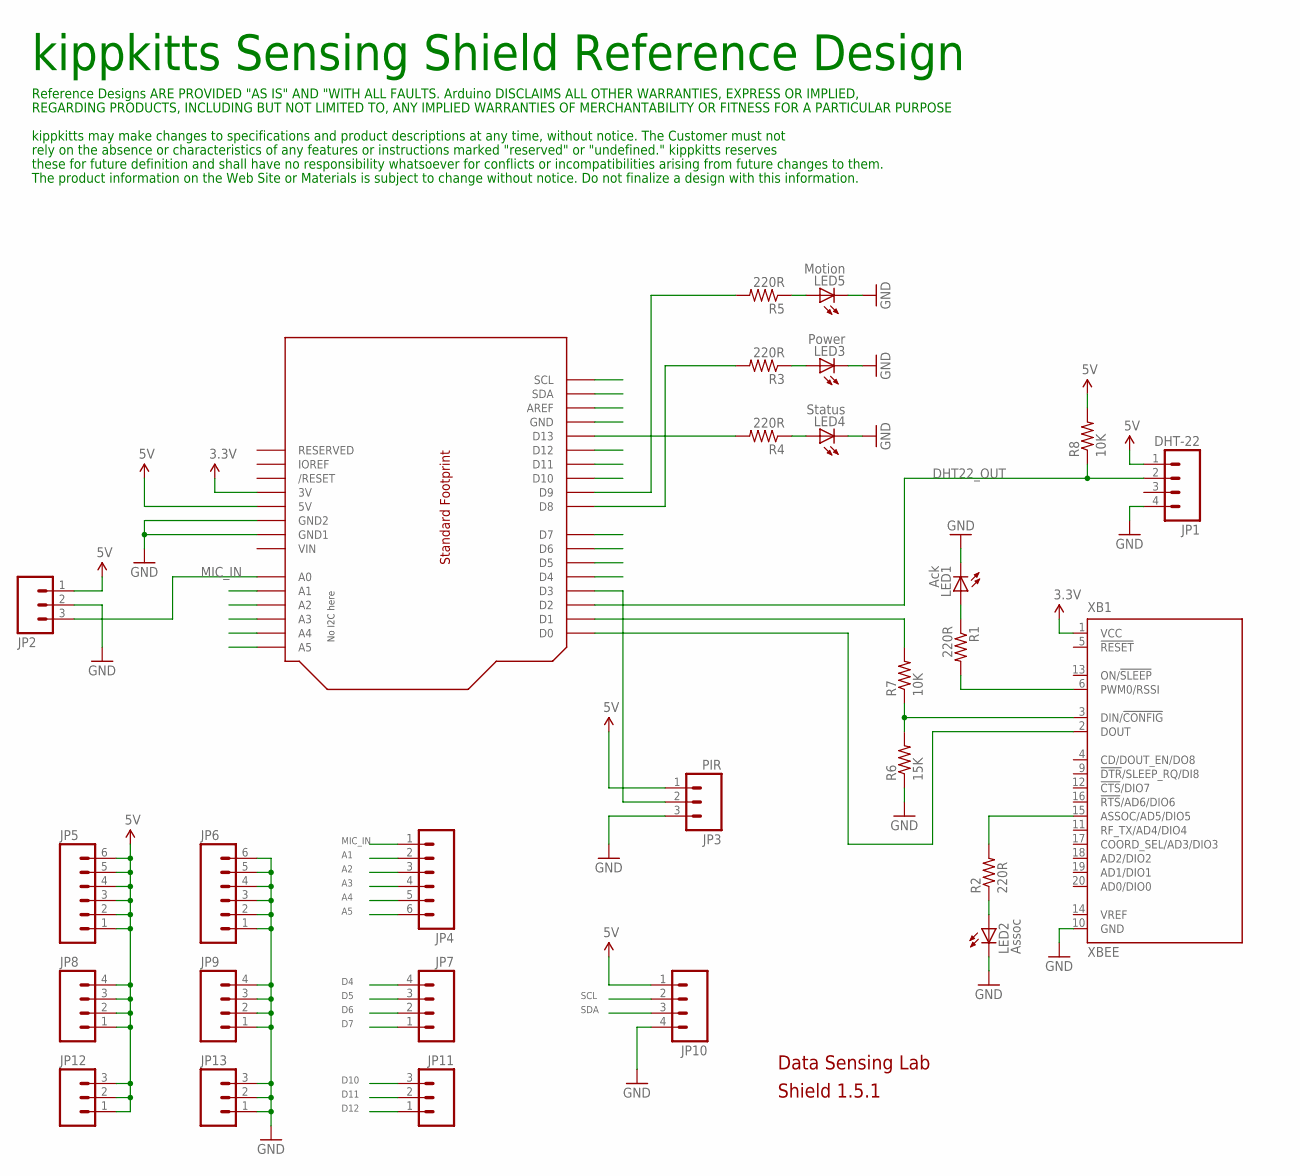
[picture p33: schematic sensing_lab_shield_1-5-1.sch]

Parts:
JP1: DHT-22; 1X04
JP2: M03POLAR_LOCK; MOLEX-1X3_LOCK
JP3: PIR; SCREWTERMINAL-3.5MM-3_LOCK.007S
JP4, JP5, JP6: M06SIP; 1X06
JP7, JP8, JP9, JP10: M04PTH; 1X04
JP11, JP12, JP13: M03PTH; 1X03
LED1: Ack; LED3MM
LED2: Assoc; LED3MM
LED3: Power; LED3MM
LED4: Status; LED3MM
LED5: Motion; LED3MM
R1, R2, R3, R4, R5: 220R; 0207/10
R6: 15K; 0207/10
R7, R8: 10K; 0207/10
U1: ARDUINOR3-DIMENSION; ARDUINOR3
XB1: XBEE

Connections:
3.3V: U1.3V, XB1.1 (VCC)
3V3_ARD_TX: R6.2, R7.1, XB1.3 (DIN/!CONFIG)
5V: JP1.1, JP2.1, JP3.1, JP5.1, JP5.2, JP5.3, JP5.4, JP5.5, JP5.6, JP8.1, JP8.2, JP8.3, JP8.4, JP10.1, JP12.1, JP12.2, JP12.3, R8.2, U1.5V
A1: JP4.2, U1.A1
A2: JP4.3, U1.A2
A3: JP4.4, U1.A3
A4: JP4.5, U1.A4
A5: JP4.6, U1.A5
ARD_RX: U1.D0, XB1.2 (DOUT)
ARD_TX: R7.2, U1.D1
D4: JP7.4, U1.D4
D5: JP7.3, U1.D5
D6: JP7.2, U1.D6
D7: JP7.1, U1.D7
D10: JP11.3, U1.D10
D11: JP11.2, U1.D11
D12: JP11.1, U1.D12
DHT22_OUT: JP1.2, R8.1, U1.D2
GND: JP1.4, JP2.2, JP3.3, JP6.1, JP6.2, JP6.3, JP6.4, JP6.5, JP6.6, JP9.1, JP9.2, JP9.3, JP9.4, JP10.4, JP13.1, JP13.2, JP13.3, LED1.K (C), LED2.K (C), LED3.K (C), LED4.K (C), LED5.K (C), R6.1, U1.GND1, U1.GND2, XB1.10 (GND)
MIC_IN: JP2.3, JP4.1, U1.A0
unnamed: LED1.A, R1.1
unnamed: LED2.A, R2.1
unnamed: R1.2, XB1.6 (PWM0/RSSI)
unnamed: R2.2, XB1.15 (ASSOC/AD5/DIO5)
unnamed: LED3.A, R3.1
unnamed: R5.2, U1.D9
unnamed: LED5.A, R5.1
unnamed: R3.2, U1.D8
unnamed: LED4.A, R4.1
unnamed: R4.2, U1.D13
unnamed: JP3.2, U1.D3
SCL: JP10.2, U1.SCL
SDA: JP10.3, U1.SDA
VIN: U1.VIN

Notes on the sheet:
Data Sensing Lab
Shield 1.5.1
kippkitts Sensing Shield Reference Design
Reference Designs ARE PROVIDED "AS IS" AND "WITH ALL FAULTS. Arduino DISCLAIMS ALL OTHER WARRANTIES, EXPRESS OR IMPLIED,
kippkitts may make changes to specifications and product descriptions at any time, without notice. The Customer must not
REGARDING PRODUCTS, INCLUDING BUT NOT LIMITED TO, ANY IMPLIED WARRANTIES OF MERCHANTABILITY OR FITNESS FOR A PARTICULAR PURPOSE
rely on the absence or characteristics of any features or instructions marked "reserved" or "undefined." kippkitts reserves
these for future definition and shall have no responsibility whatsoever for conflicts or incompatibilities arising from future changes to them.
The product information on the Web Site or Materials is subject to change without notice. Do not finalize a design with this information.

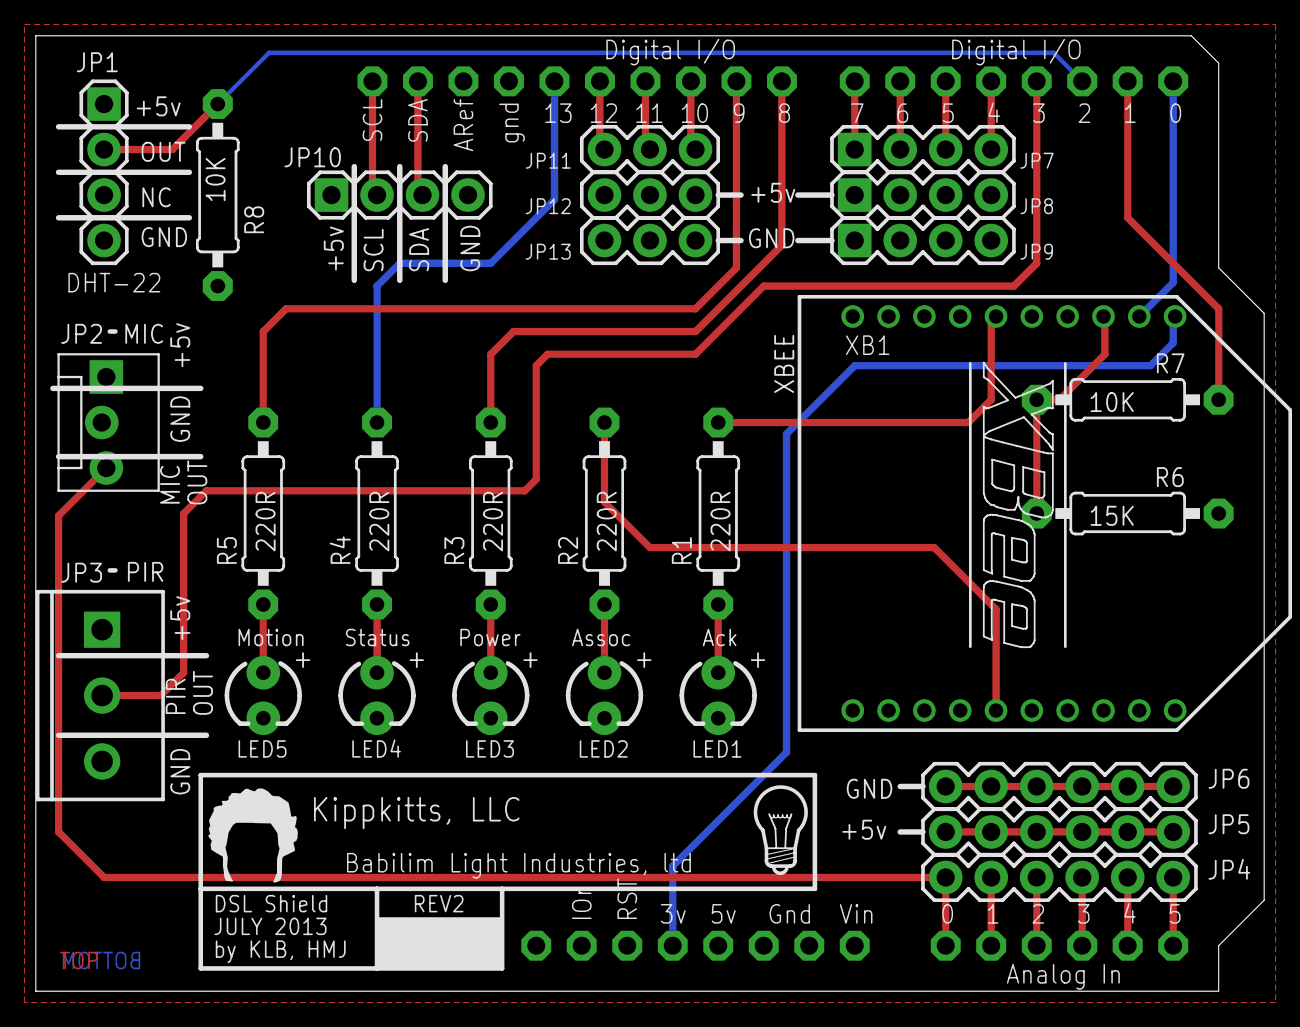
[picture p34: board sensing_lab_shield_1-5-1.brd from above]

Board: 2 copper layers, 68.6 x 53.3 mm, 30 parts (0 on the bottom side), 33 nets.

Other parts of the board:
U$6: BABILIM_7.5MM
U$7: TOP_DOCU_5MM
