kippkitts/DataSensingLab/(commit log)

2014-02-20 reorganized folders
    [sensing_lab_shield_1-5-1.brd, sensing_lab_shield_1-5-1.sch]
2014-02-28 Added kippkitts testing program
    This is the starting point for programs that run on the sensor motes
2014-02-28 Added new version of DSL Arduino code, which allows the sensor mote to interface with a Processing based graphical user interface.
2014-03-10 Reorganize Folders
    [sensing_lab_shield_1-5-1.brd, sensing_lab_shield_1-5-1.sch]
2014-03-26 Moved Google IO 2013 files into DSL
    [SensorMoteSMT_V1.1MCAD.brd, SensorMoteSMT_V1.1MCAD.sch]
2014-08-04 ONA Sensor Mote Project
    Files for the MSP430 + XBee sensor mote
    [ONA_SensorMoteBOM_V1.xlsx, ONA_SensorMoteV1.brd, ONA_SensorMoteV1.sch]
2014-12-17 Removed and Replaced Bad Arduino Code
2015-03-29 Added Schematic PDFs, Fixed Code
    Added Eagle PDFs for all configurations, deleted broken Arduino code,
    added basic Arduino test program
    [SensorMoteV0_9.ino]
