kippkitts/DataSensingLab/(notices)

Notices in the files:
ONA_Sensor_Mote/Circuit Board/ONA_SensorMote_V1/ONA_SensorMoteV1.sch:
to use the CERN OHL, in unmodified form only, for the distribution of
their own Open Hardware designs. Any other right is reserved. Release
of hardware designs under the CERN OHL does not constitute an
endorsement of the licensor or its designs nor does it imply any
available under the conditions of this Licence. The Documentation may
granted under this Licence, the Licensee irrevocably accepts these
viewable with a tool licensed under an OSI-approved license if the
proprietary tool can create it; and
e) license the modified Documentation under the terms and conditions
rights granted under this Licence. The Licensee warrants that it does
